particle-iot/power-module/PM-BAT/PM-BAT-V0.5-DXF for shielding case/PM-BAT v0.5-35X22.86-DXF-MAX Components Height 2mm.dxf

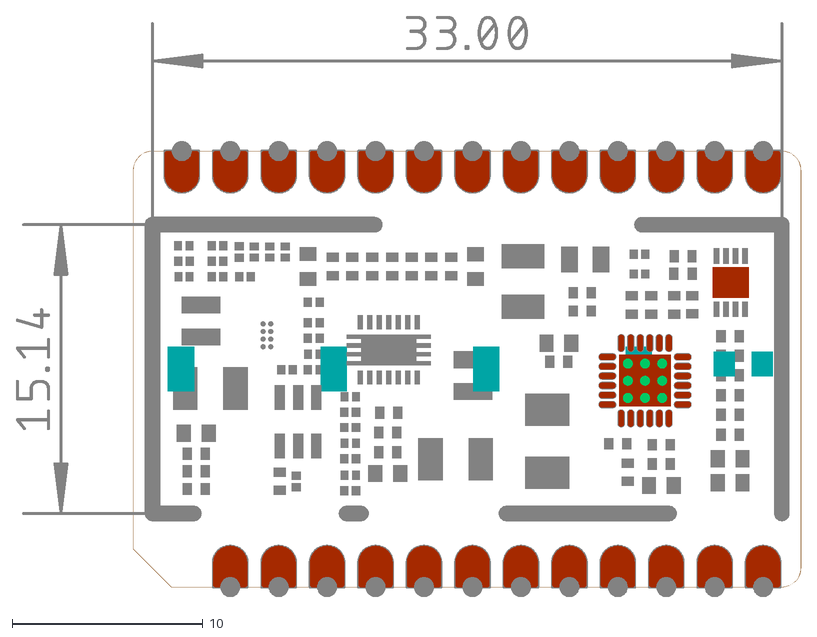
[picture p1: CAD file, 2024-05-06]
PM-BAT/PM-BAT-V0.5-DXF for shielding case/PM-BAT v0.5-35X22.86-DXF-MAX Components Height 2mm.dxf
41.2 x 30.5
