particle-iot/power-module/PM-BAT/V1.0/PM-BAT v1.0-35X22.86-B.dxf

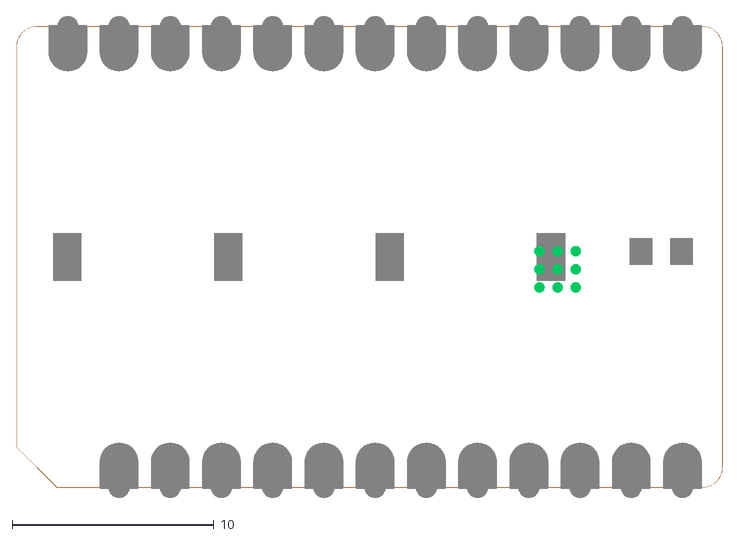
[picture p2: CAD file, 2026-09-03]
PM-BAT/V1.0/PM-BAT v1.0-35X22.86-B.dxf
35.0 x 23.9
