particle-iot/power-module/PM-DC/PM-DC-V0.4 DXF for shielding case/PM_DC_v0.4DXF-MAX Components Height 2mm.dxf

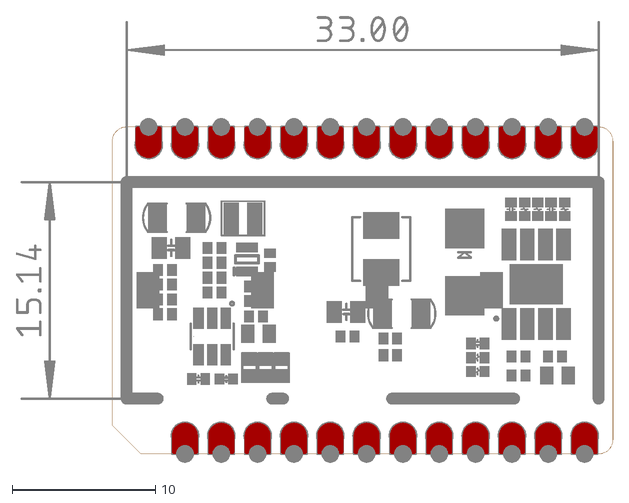
[picture p3: CAD file, 2024-05-06]
PM-DC/PM-DC-V0.4 DXF for shielding case/PM_DC_v0.4DXF-MAX Components Height 2mm.dxf
41.7 x 31.2
