particle-iot/power-module/PM-DC/V1.0/PM_DC_v1.0-T.dxf

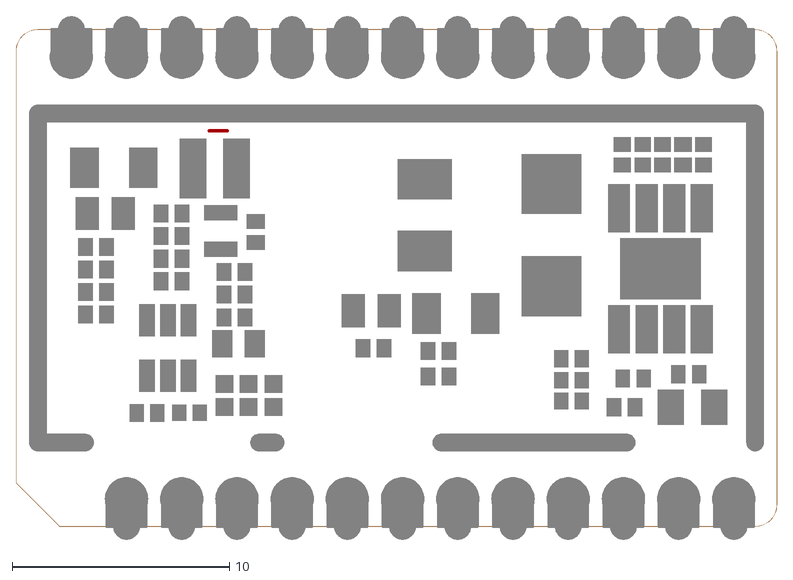
[picture p4: CAD file, 2026-09-03]
PM-DC/V1.0/PM_DC_v1.0-T.dxf
35.0 x 24.1
