particle-iot/power-module/PM-BAT/V1.0/PM-BAT v1.0-35X22.86-T.dxf

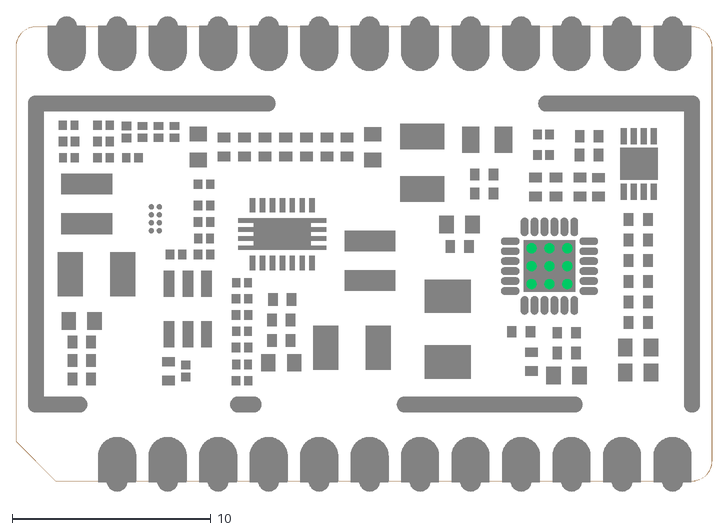
[picture p5: CAD file, 2026-09-03]
PM-BAT/V1.0/PM-BAT v1.0-35X22.86-T.dxf
35.0 x 23.9
