particle-iot/power-module/PM-DC/V1.0/PM_DC_v1.0-B.dxf

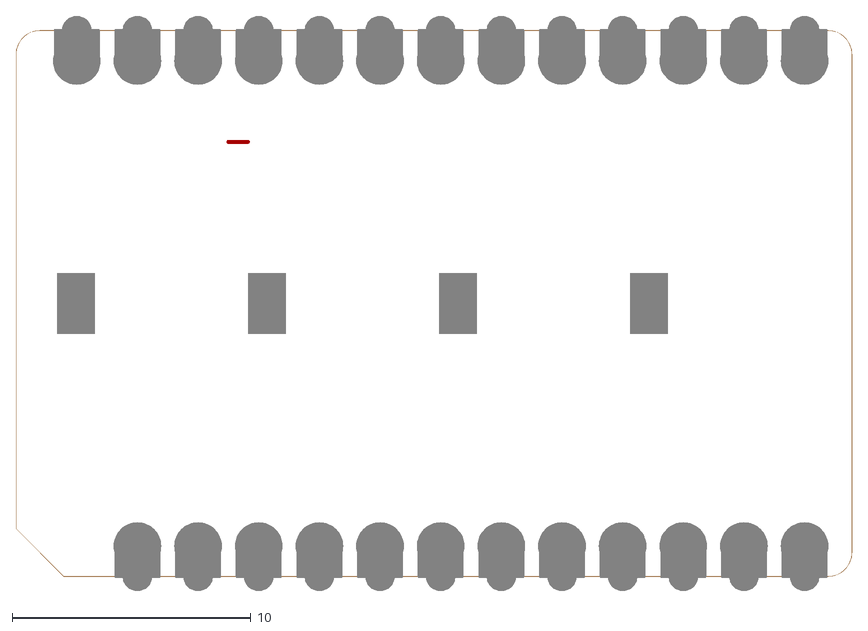
[picture p6: CAD file, 2026-09-03]
PM-DC/V1.0/PM_DC_v1.0-B.dxf
35.0 x 24.1
