particle-iot/power-module/PM-BAT/PM-BAT-V0.5-DXF for shielding case/PM-BAT v0.5-35X22.86-DXF_MAX Components Height 2mm.pdf

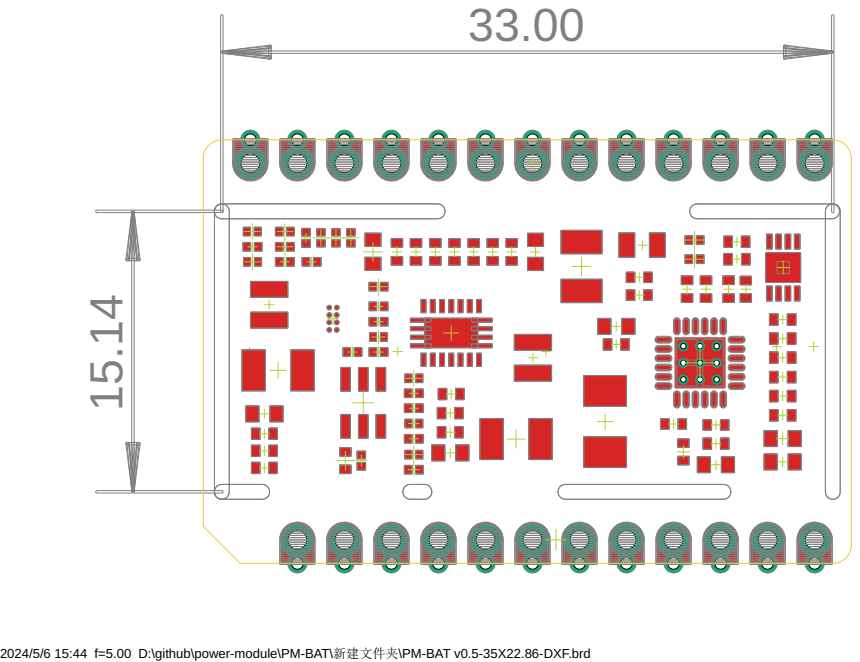
[picture p7: page 1]

2024/5/6 15:44 f=5.00 D:\github\power-module\PM-BAT\新建文件夹\PM-BAT v0.5-35X22.86-DXF.brd
