particle-iot/power-module/PM-DC/PM-DC-V0.4 DXF for shielding case/PM_DC_v0.4DXF-MAX Components Height 2mm.pdf

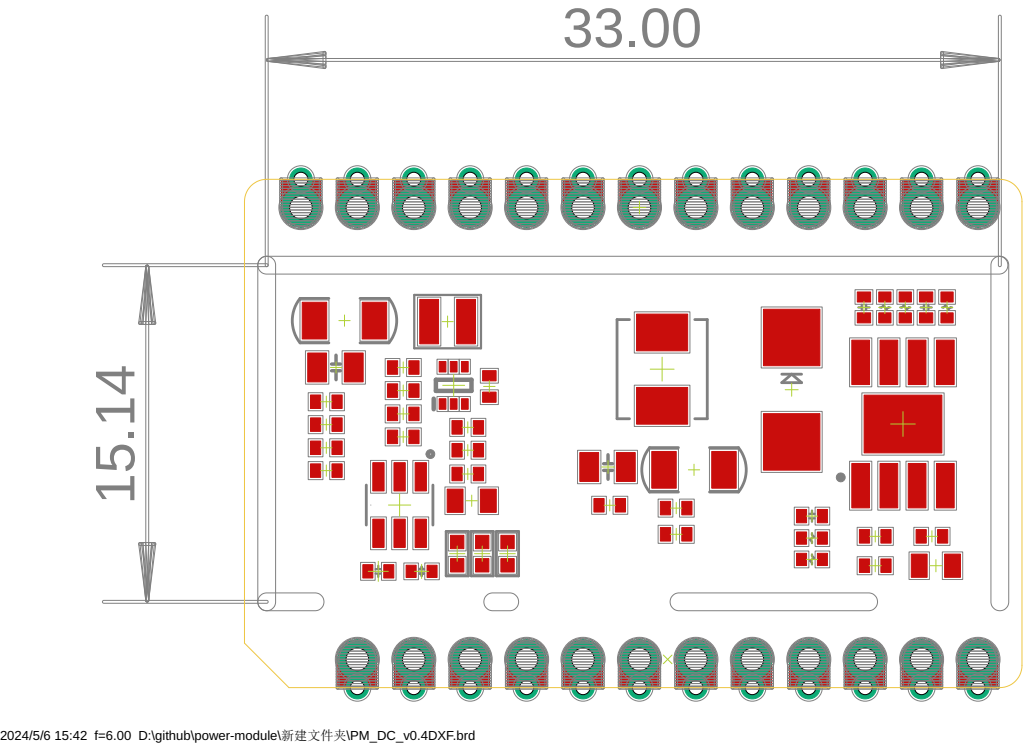
[picture p8: page 1]

2024/5/6 15:42 f=6.00 D:\github\power-module\新建文件夹\PM_DC_v0.4DXF.brd
