particle-iot/power-module/PM-BAT/V1.0/PM-BAT v1.0-35X22.86.pdf

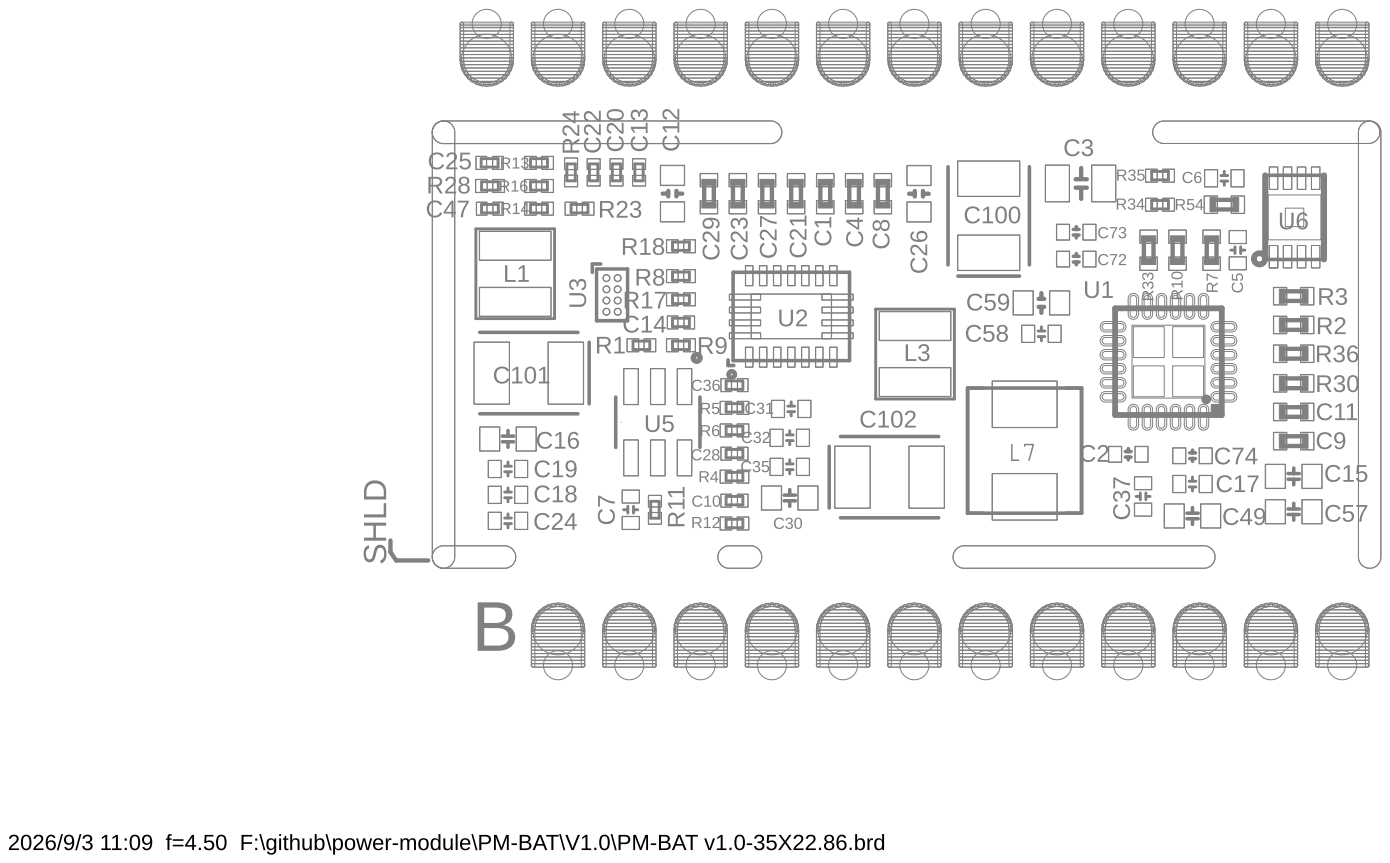
[picture p9: page 1]
