particle-iot/power-module/PM-DC/V1.0/PM_DC_v1.0.pdf

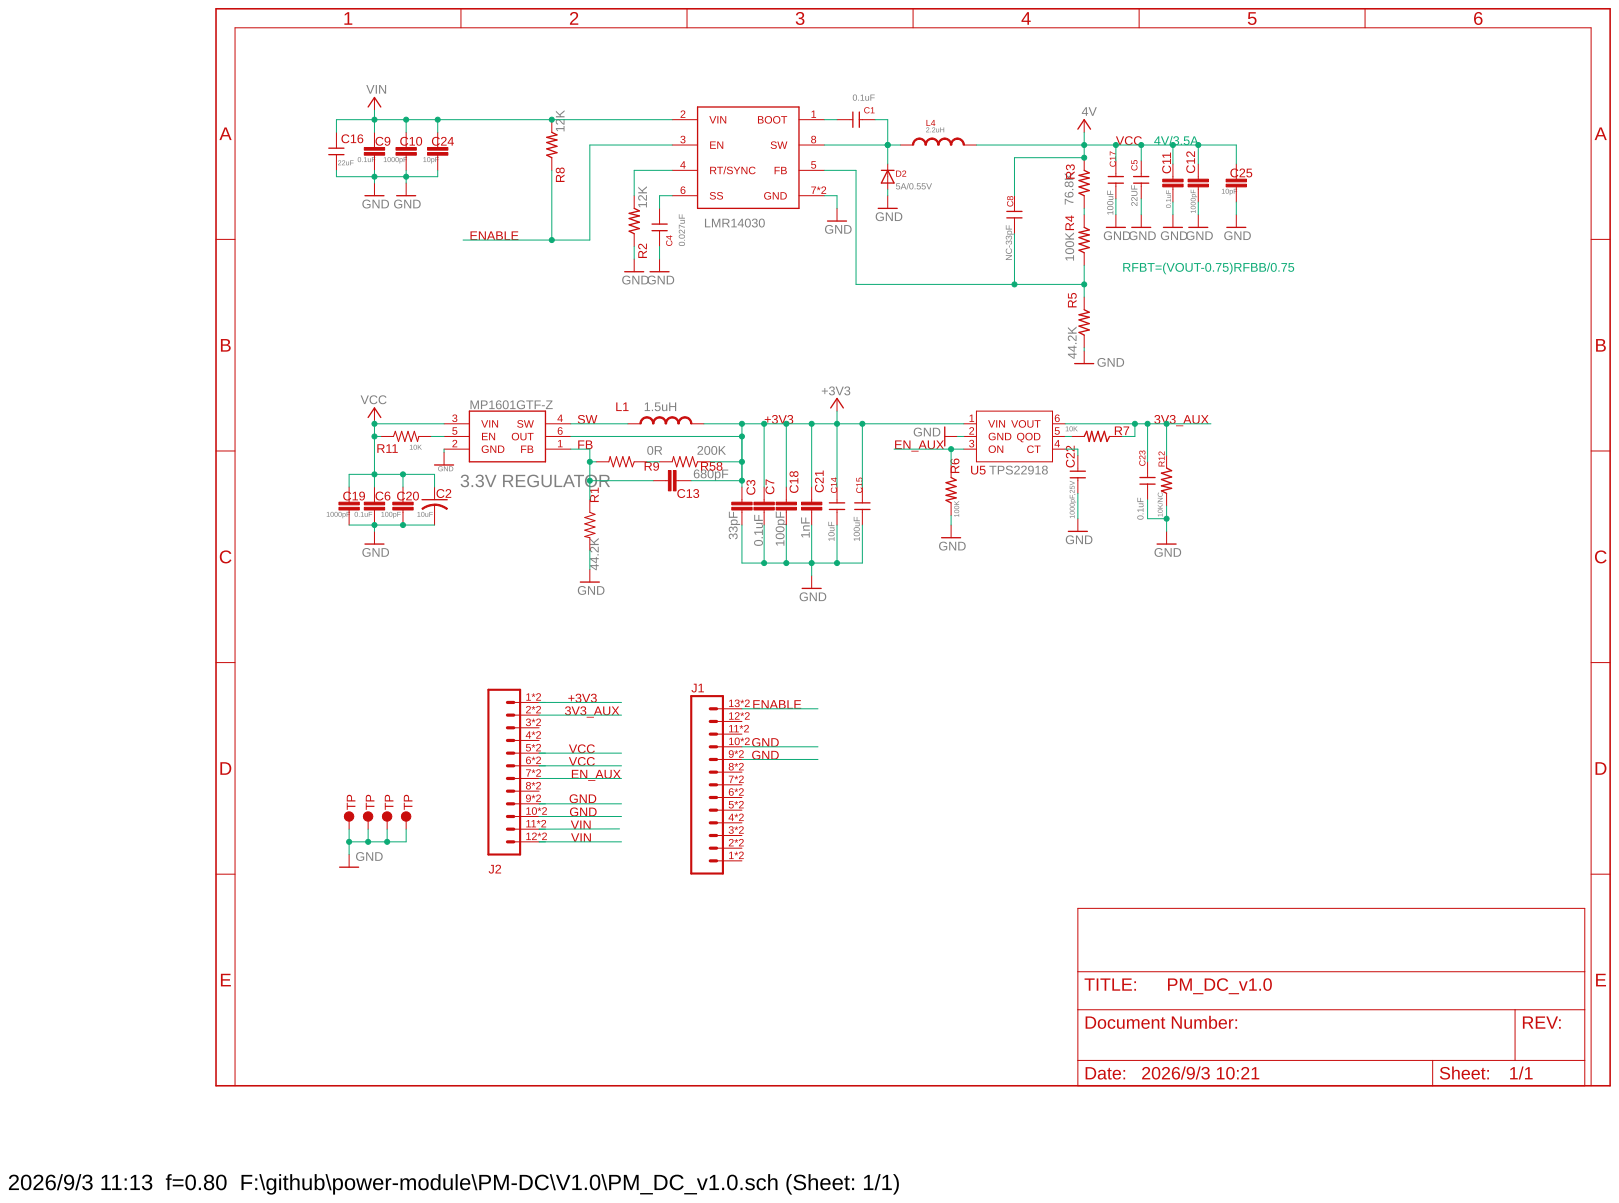
[picture p10: page 1]
