particle-iot/power-module/PM-BAT/V0.5/PM-BAT v0.5-35X22.86.pdf

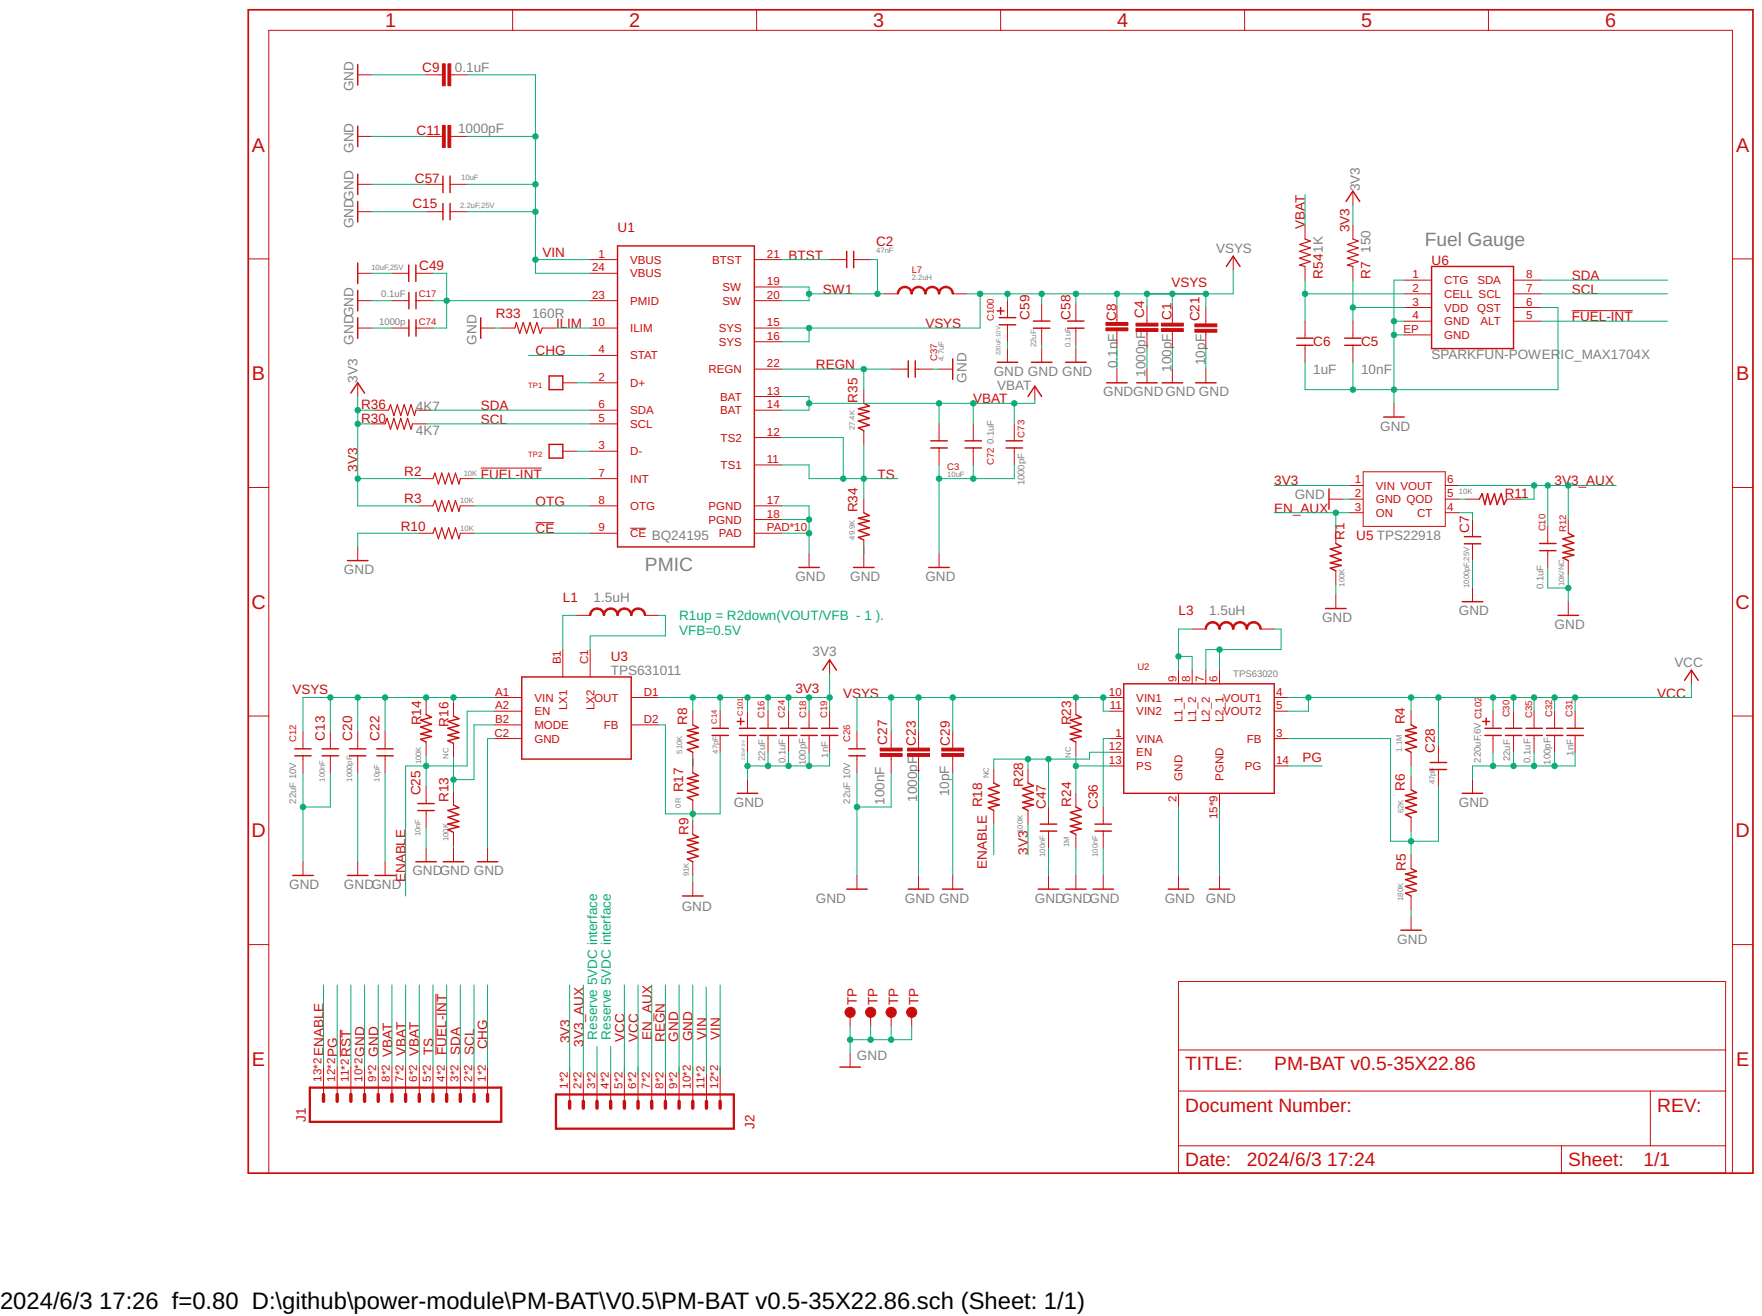
[picture p11: page 1]

Reserve 5VDC interface

2024/6/3 17:26 f=0.80 D:\github\power-module\PM-BAT\V0.5\PM-BAT v0.5-35X22.86.sch (Sheet: 1/1)
