particle-iot/power-module/PM-DC/V0.4/PM_DC_v0.4.pdf

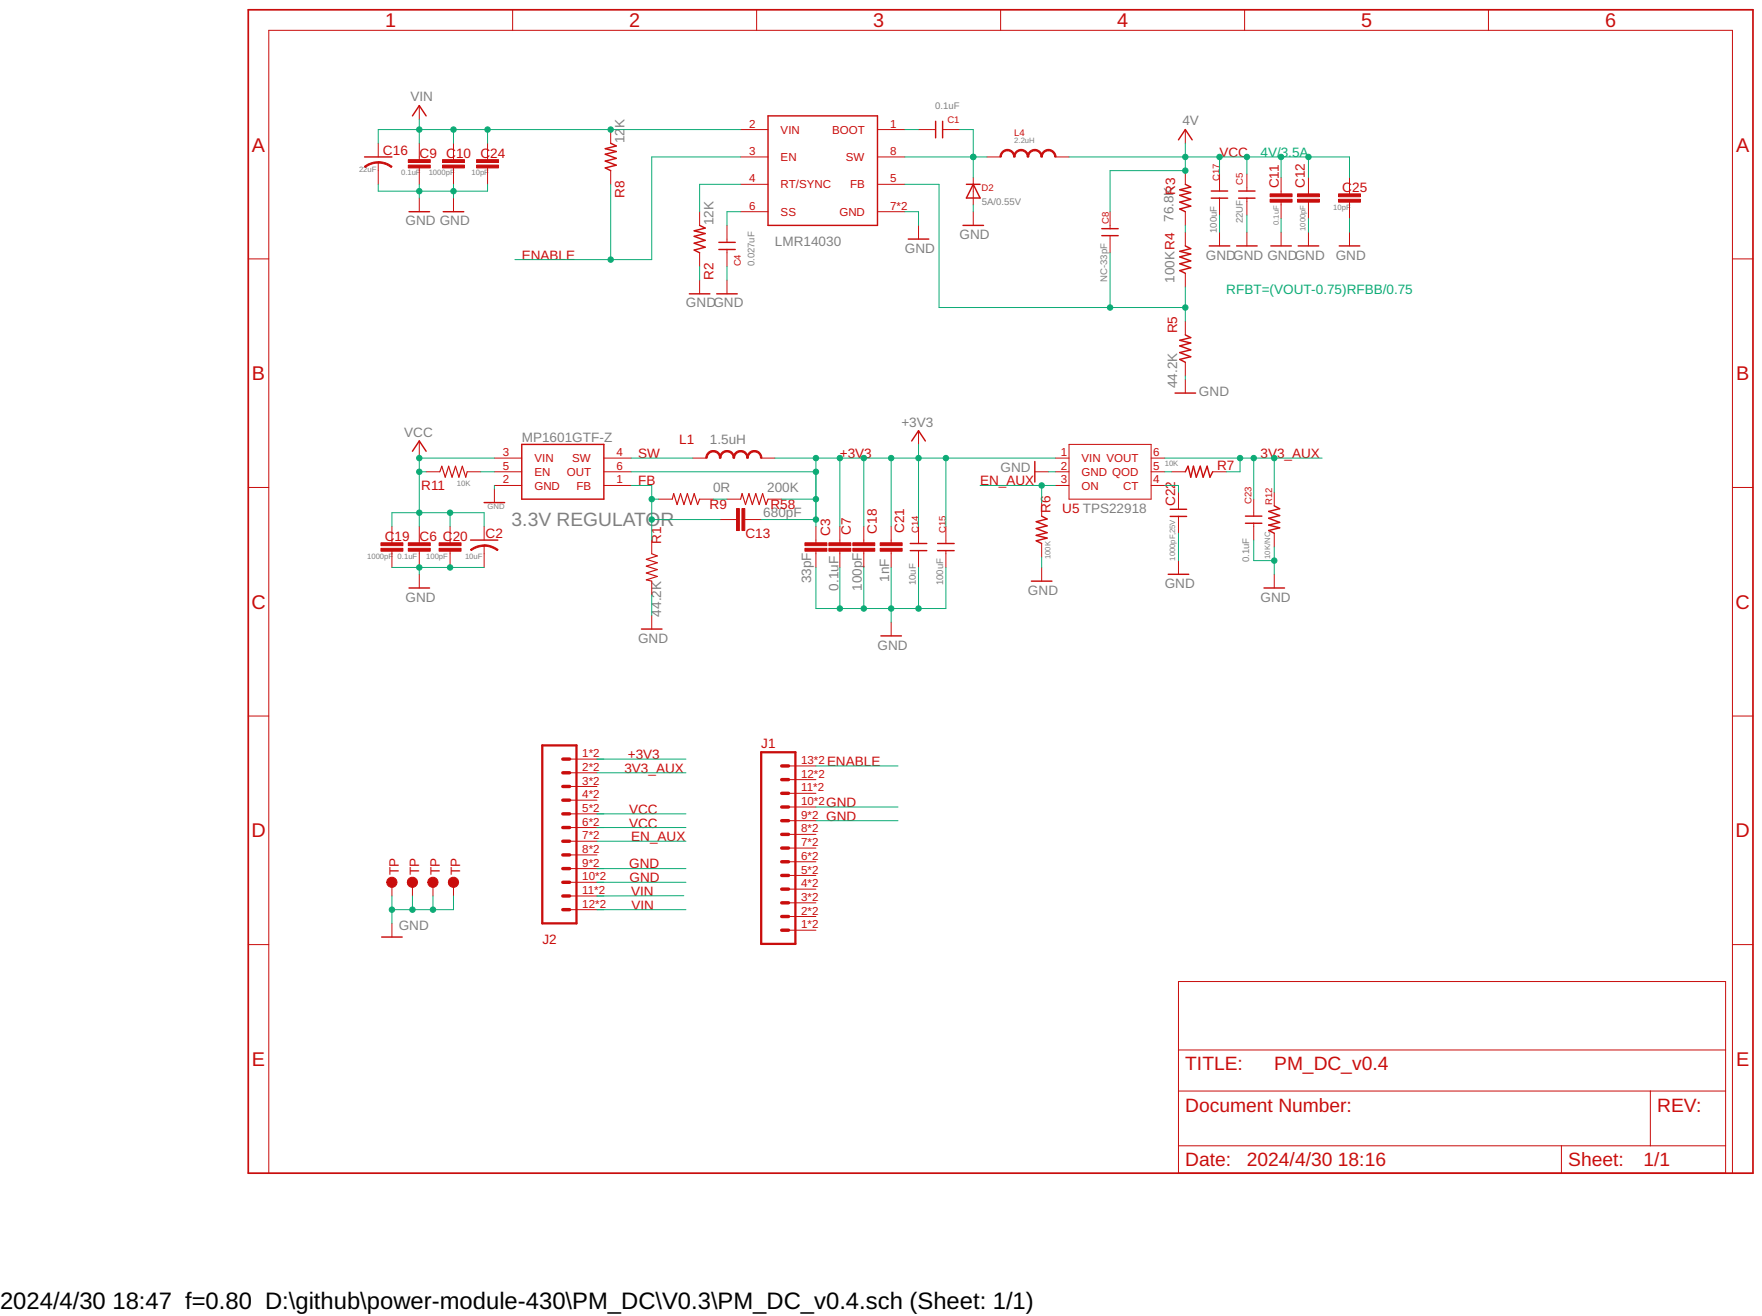
[picture p12: page 1]

2024/4/30 18:47 f=0.80 D:\github\power-module-430\PM_DC\V0.3\PM_DC_v0.4.sch (Sheet: 1/1)
