particle-iot/power-module/PM-BAT/v0.4/PM-BAT v0.4-35X22.86.pdf

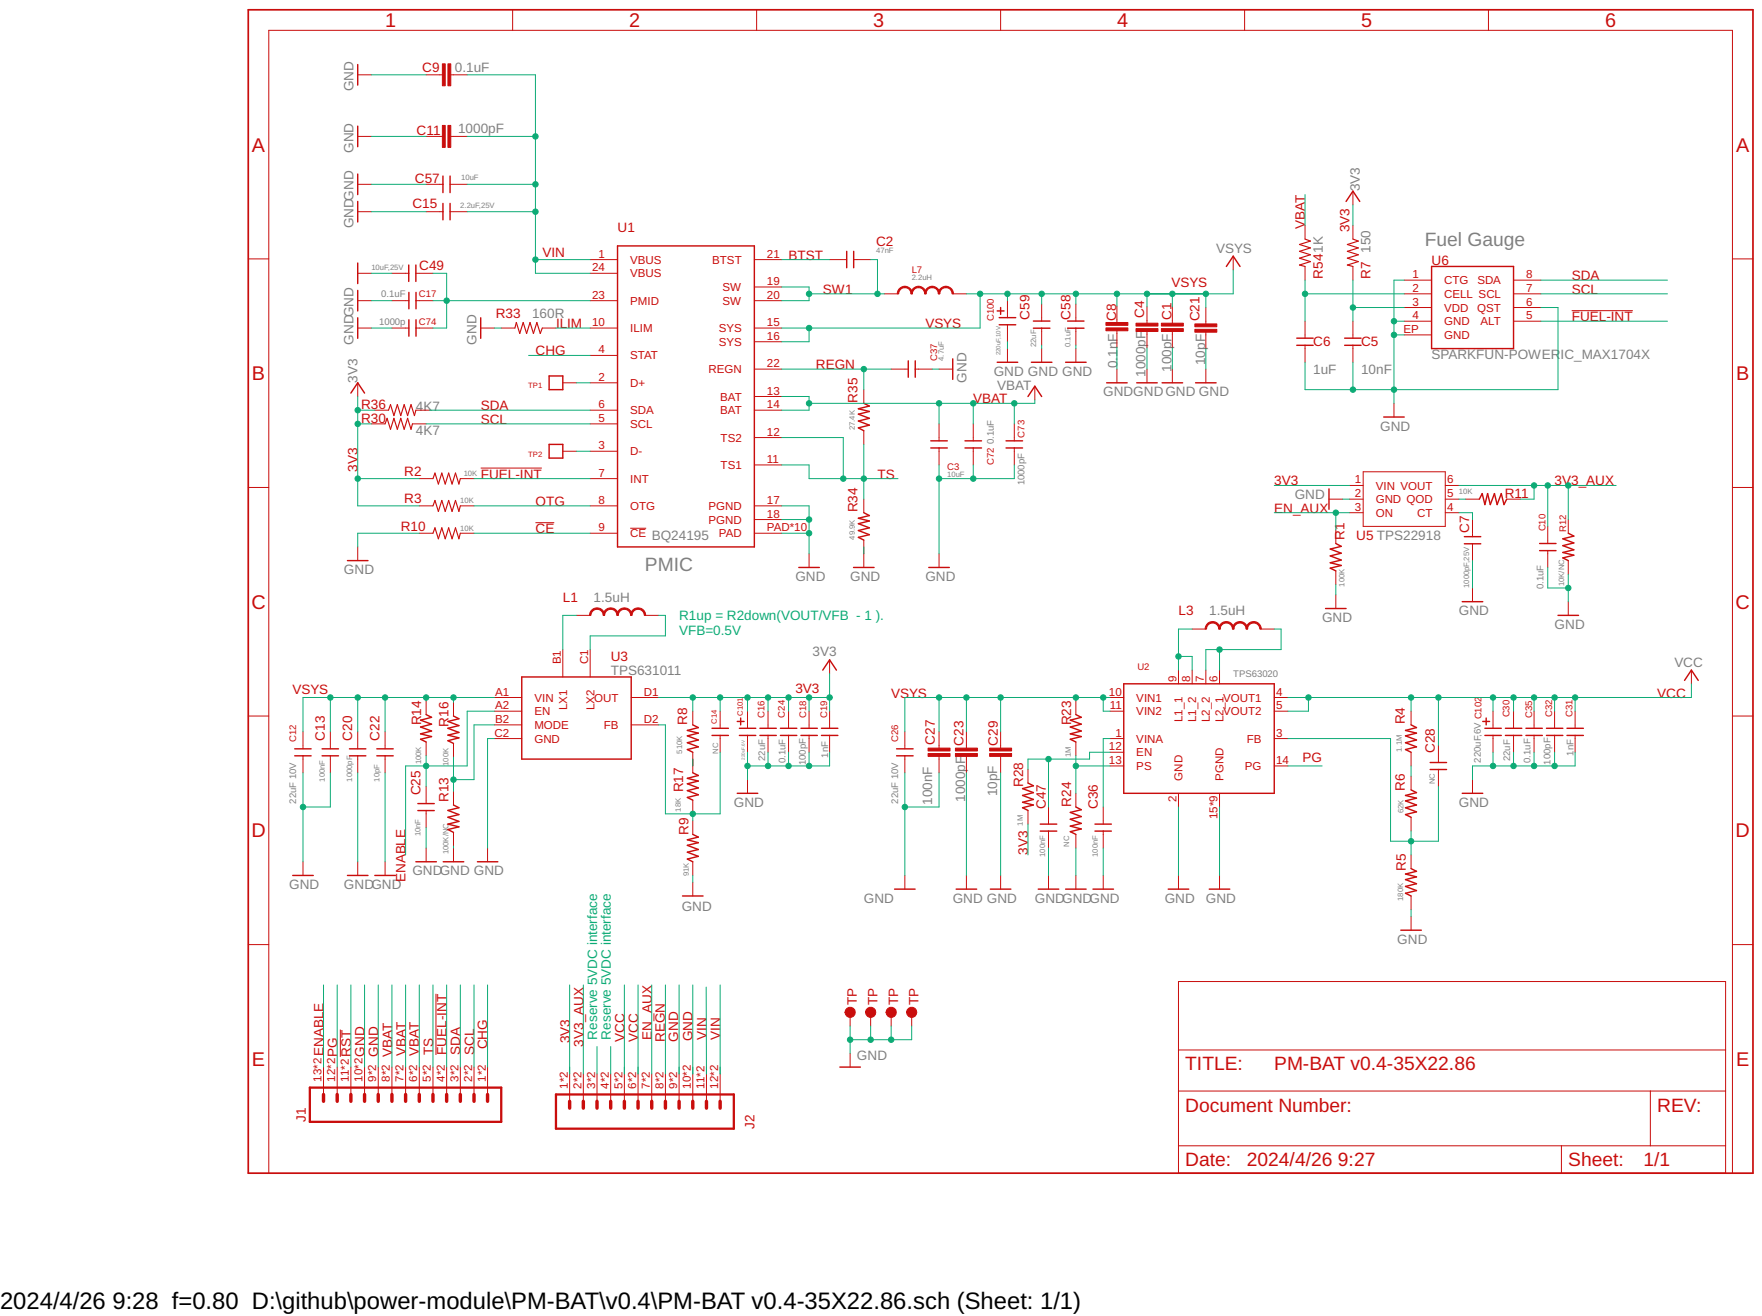
[picture p13: page 1]

Reserve 5VDC interface

2024/4/26 9:28 f=0.80 D:\github\power-module\PM-BAT\v0.4\PM-BAT v0.4-35X22.86.sch (Sheet: 1/1)
