particle-iot/power-module/PM-DC/V0.3/PM_DC_v0.3.pdf

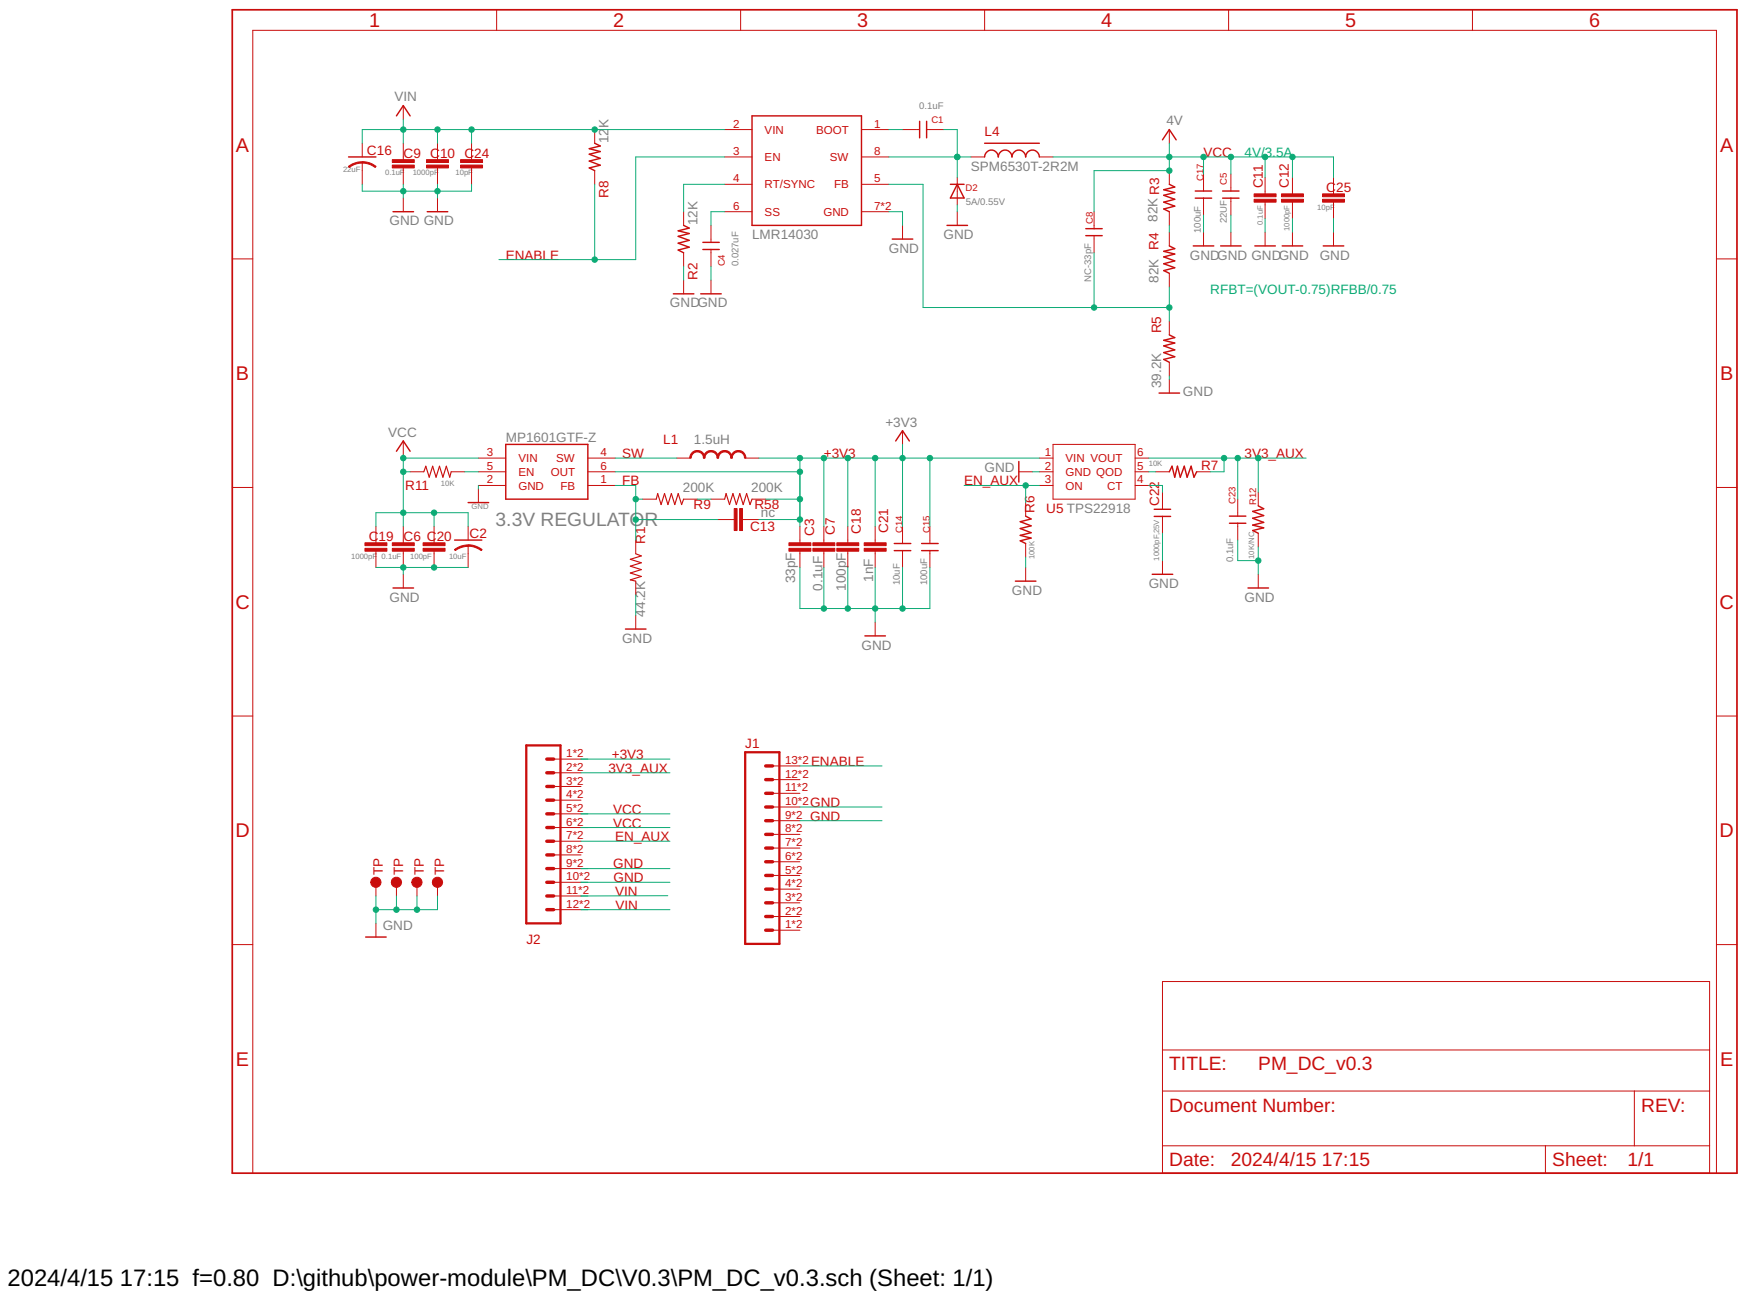
[picture p14: page 1]

2024/4/15 17:15 f=0.80 D:\github\power-module\PM_DC\V0.3\PM_DC_v0.3.sch (Sheet: 1/1)
