particle-iot/power-module/PM-BAT/V0.1/ELEKTRA-PMIC v0.1-20240201.pdf

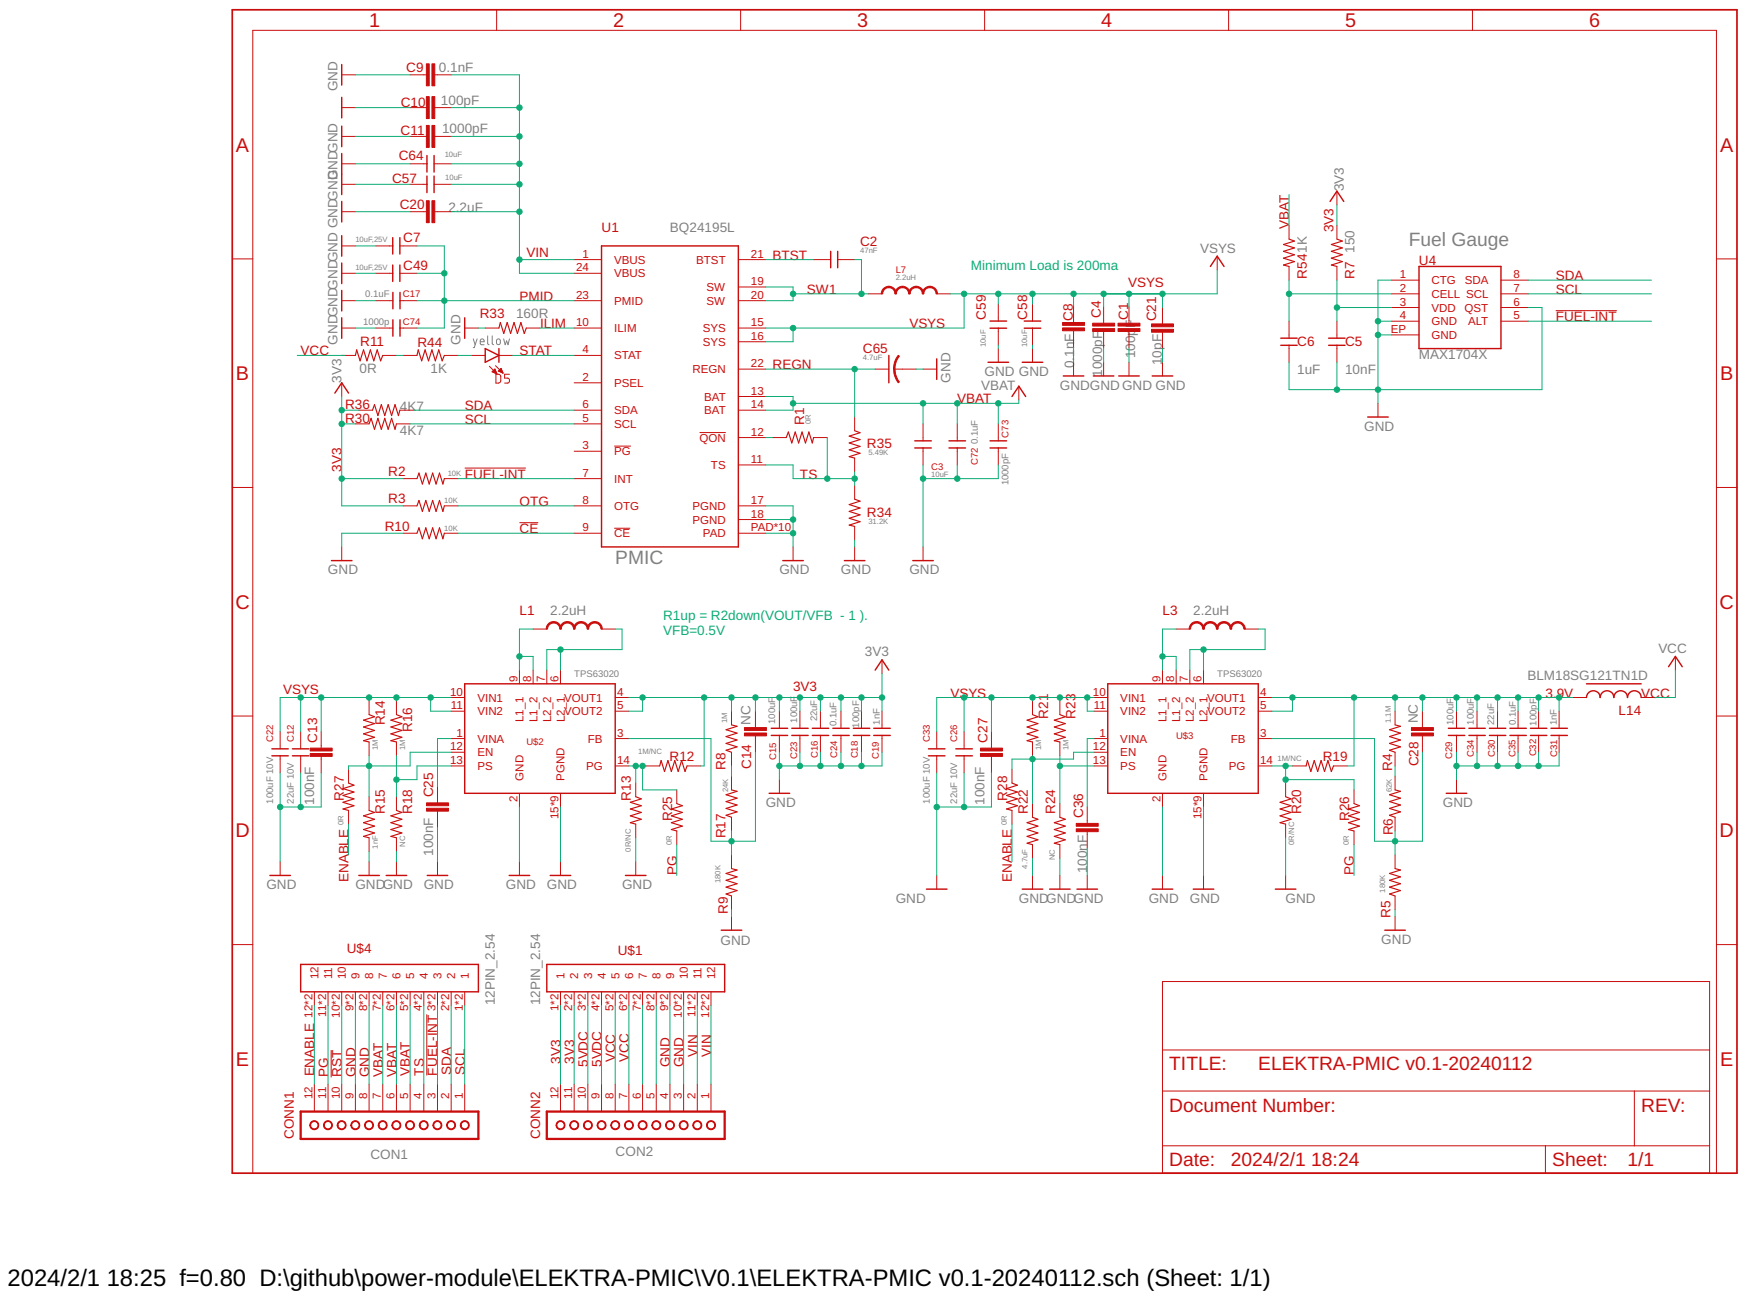
[picture p15: page 1]

2024/2/1 18:25 f=0.80 D:\github\power-module\ELEKTRA-PMIC\V0.1\ELEKTRA-PMIC v0.1-20240112.sch (Sheet: 1/1)
