particle-iot/power-module/PM-DC/V0.1/ELEKTRA-BENCH v0.1-20240201.pdf

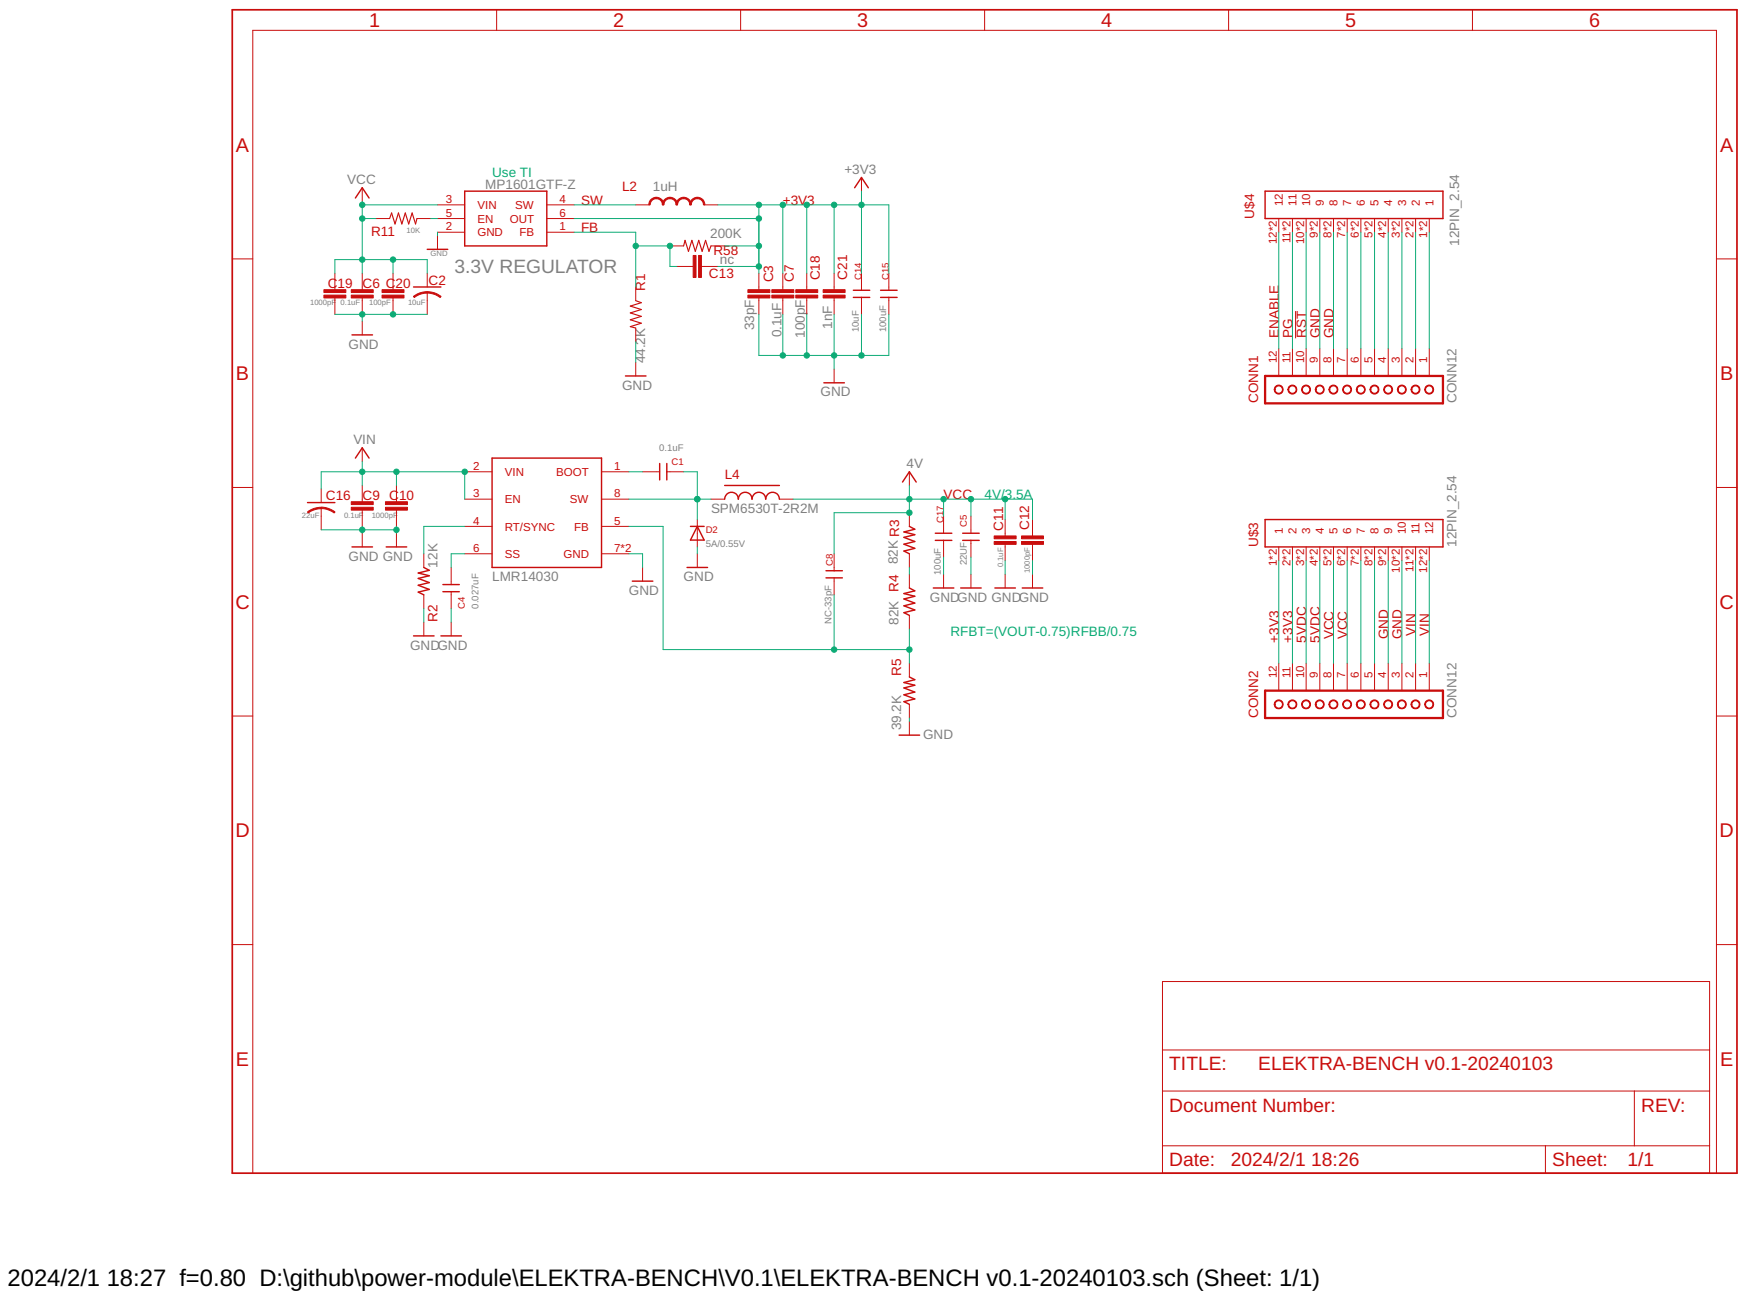
[picture p16: page 1]

12*2 U$4 GND GND GND GND

2024/2/1 18:27 f=0.80 D:\github\power-module\ELEKTRA-BENCH\V0.1\ELEKTRA-BENCH v0.1-20240103.sch (Sheet: 1/1)
