particle-iot/power-module/PM-BAT/V0.5/xydate and placement for PM-BAT/PM-BAT -SMT-placement.pdf

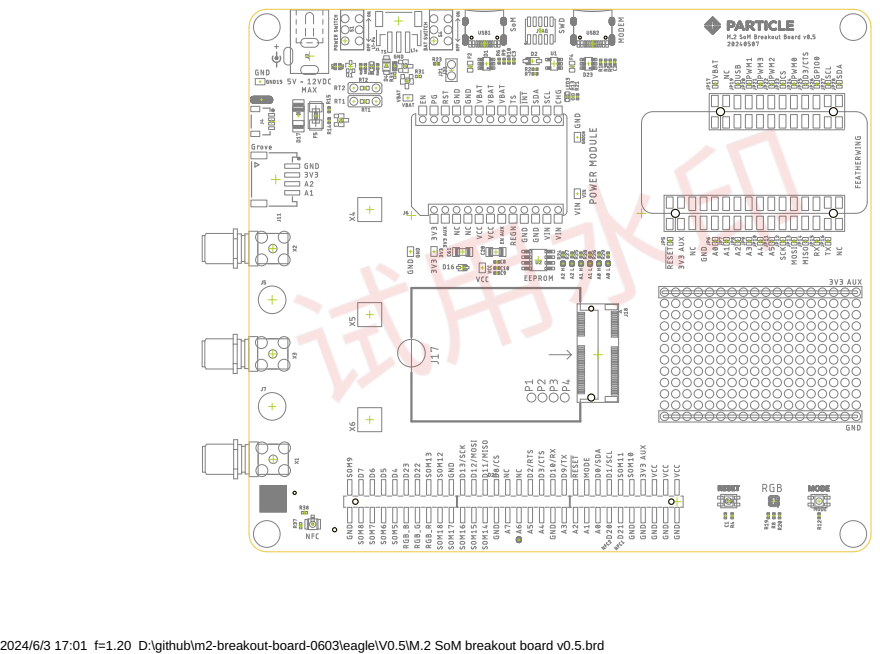
[picture p17: page 1]

2024/6/3 17:01 f=1.20 D:\github\m2-breakout-board-0603\eagle\V0.5\M.2 SoM breakout board v0.5.brd

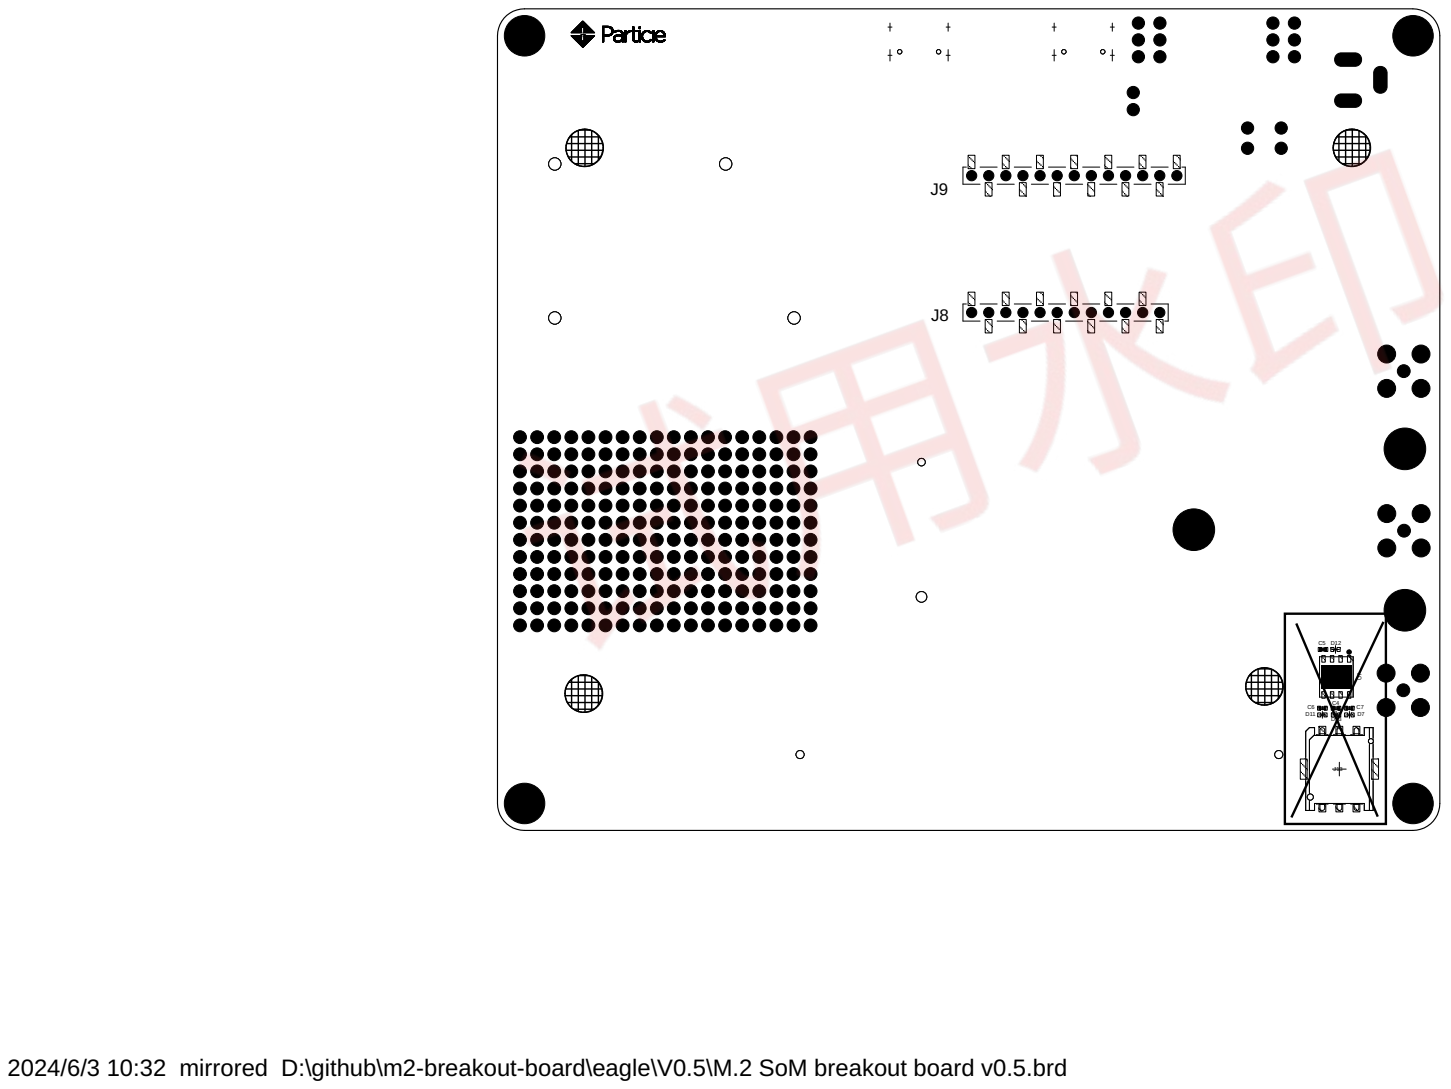
[picture p18: page 2]

2024/6/3 10:32 mirrored D:\github\m2-breakout-board\eagle\V0.5\M.2 SoM breakout board v0.5.brd
