particle-iot/power-module/PM-DC/V0.4/xydate and placement for PM-DC/PM-DC-SMT-placement.pdf

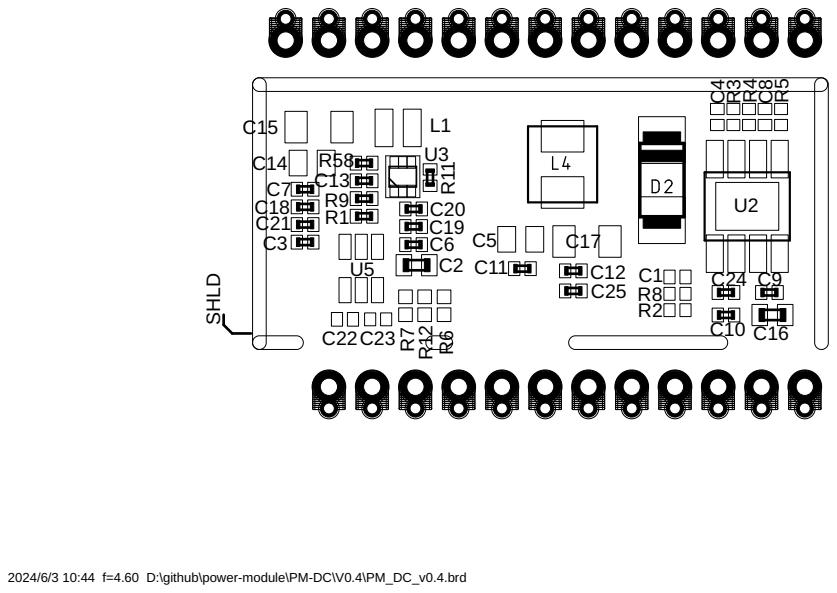
[picture p19: page 1]

2024/6/3 10:44 f=4.60 D:\github\power-module\PM-DC\V0.4\PM_DC_v0.4.brd

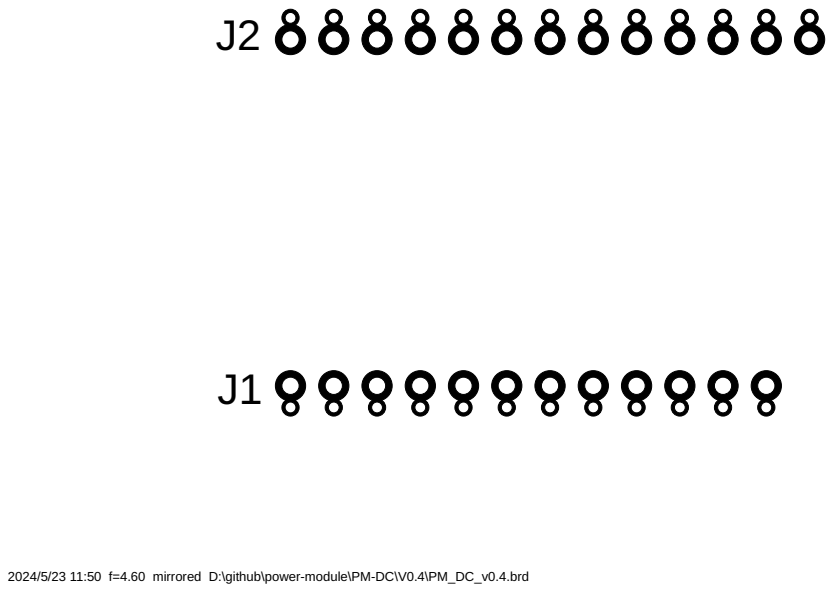
[picture p20: page 2]

2024/5/23 11:50 f=4.60 mirrored D:\github\power-module\PM-DC\V0.4\PM_DC_v0.4.brd
