particle-iot/power-module/PM-BAT/V0.1/PM-BAT/v0.4/PM-BAT v0.4-35X22.86.pdf

## Fuel Gauge

A

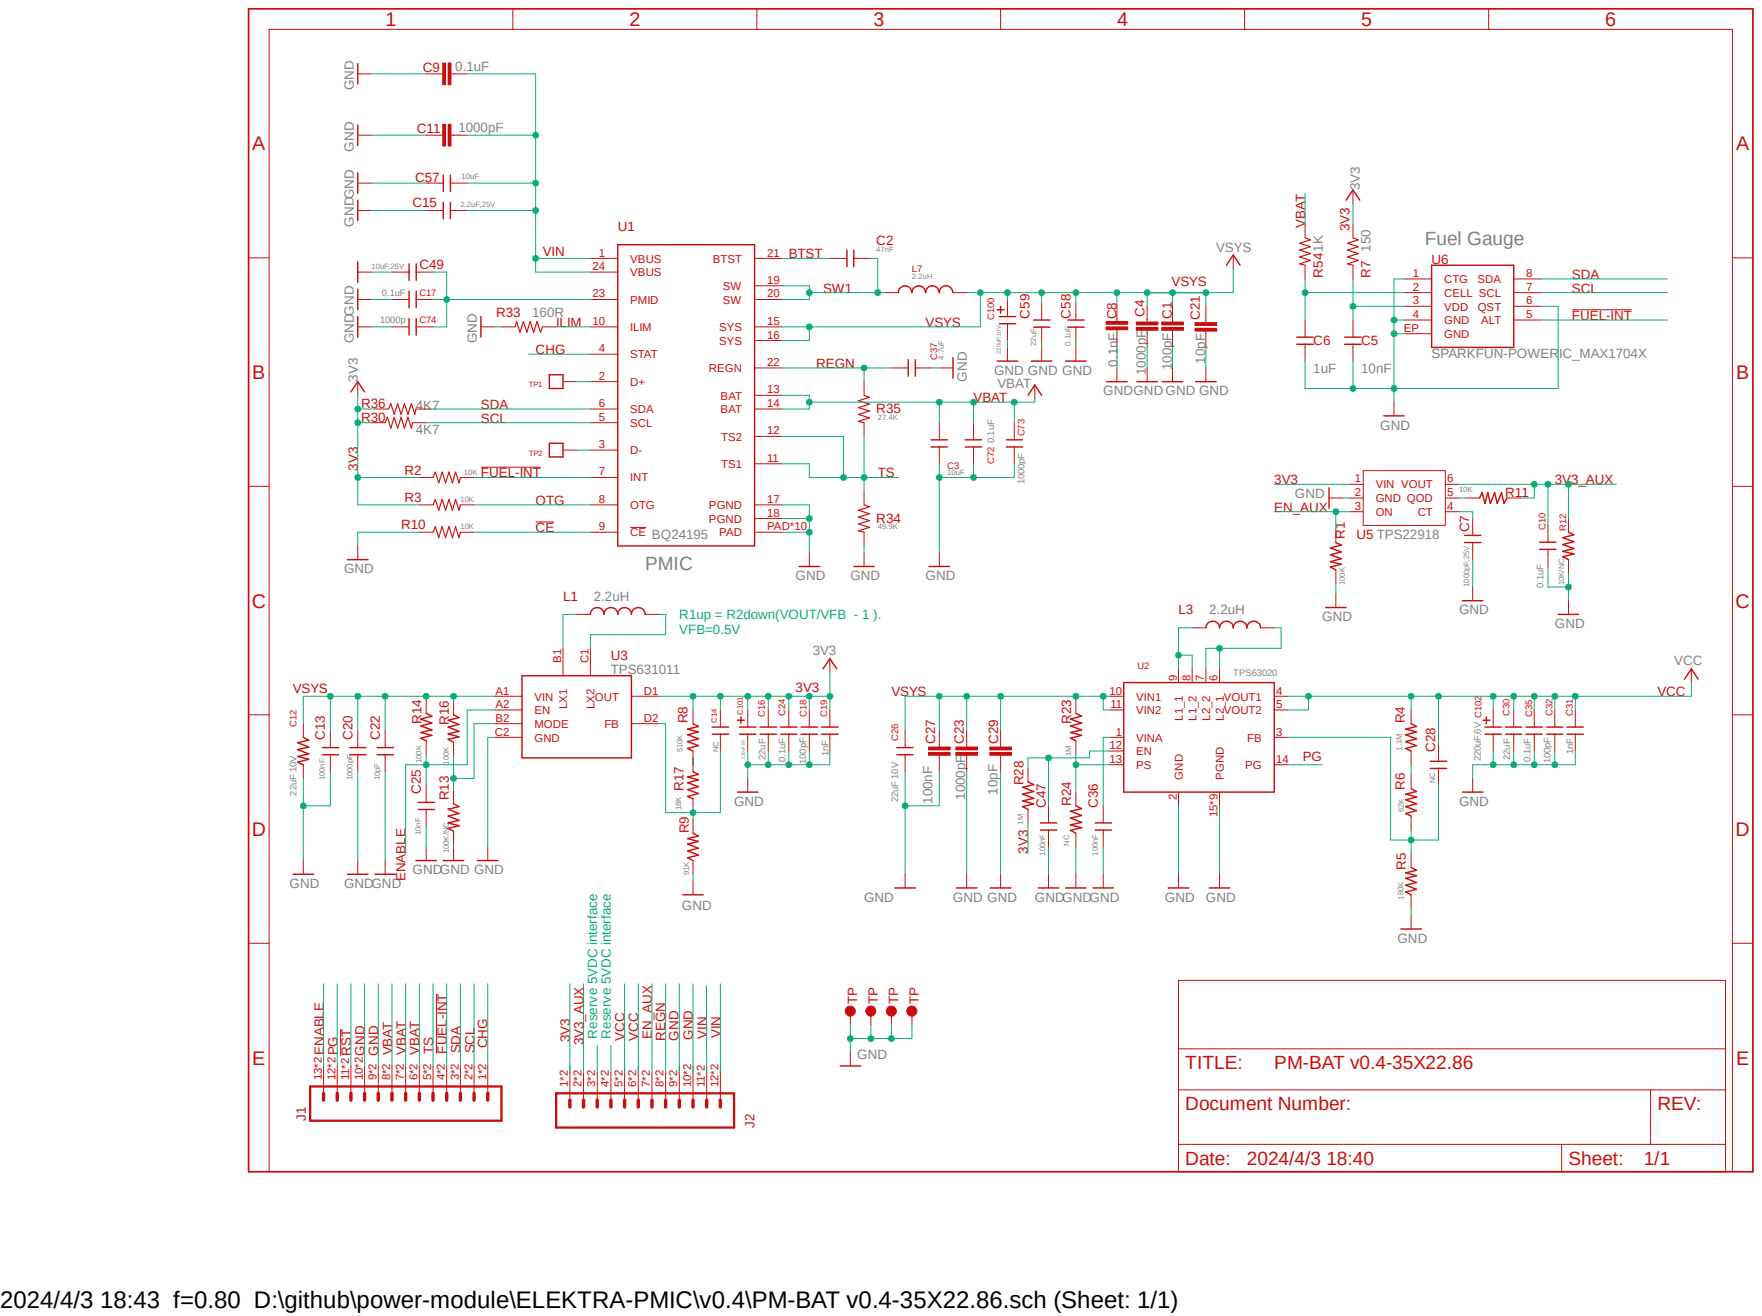
[picture p21: page 1]

4 | SPARKFUN-POWERIC_MAX1704X

Document Number: | REV:

Date: 2024/4/3 18:40 | Sheet: 1/1

2024/4/3 18:43 f=0.80 D:\github\power-module\ELEKTRA-PMIC\v0.4\PM-BAT v0.4-35X22.86.sch (Sheet: 1/1)
