particle-iot/power-module/PowerModule_TestBoard/eagle/powerModule_v0.0.1/PowerModule_Testboard.pdf

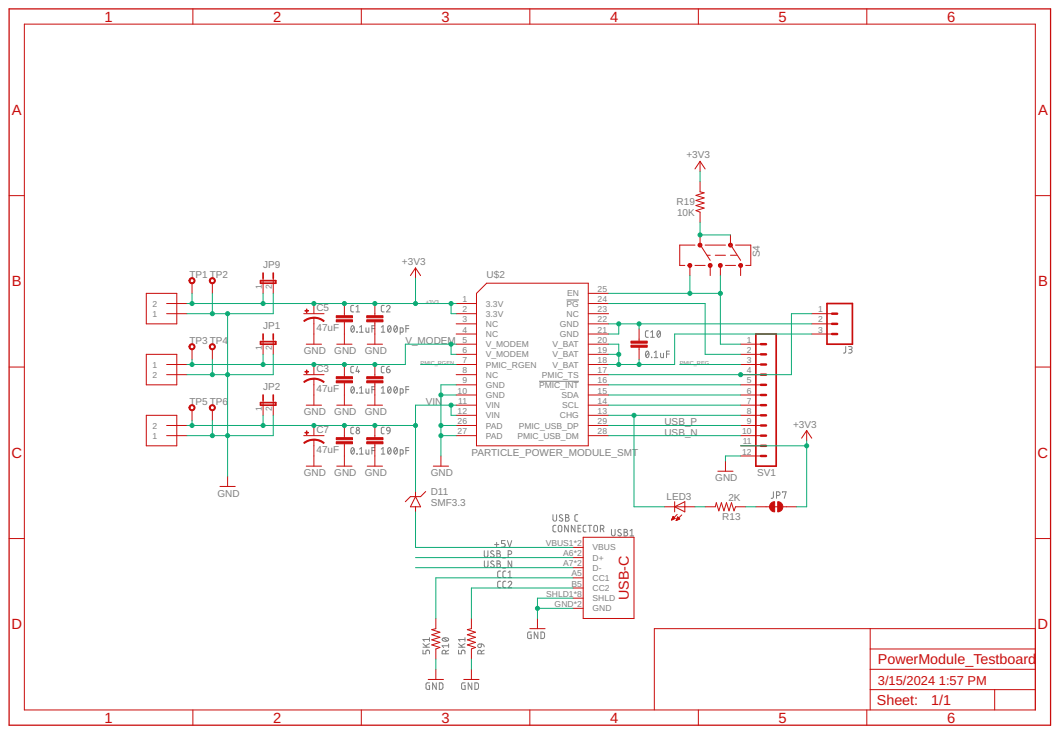
[picture p22: page 1]
