particle-iot/power-module/PM-DC/V1.0/PM_DC_v1.0.brd

## EAGLE design PM-DC/V1.0/PM_DC_v1.0.brd (2026-09-03)

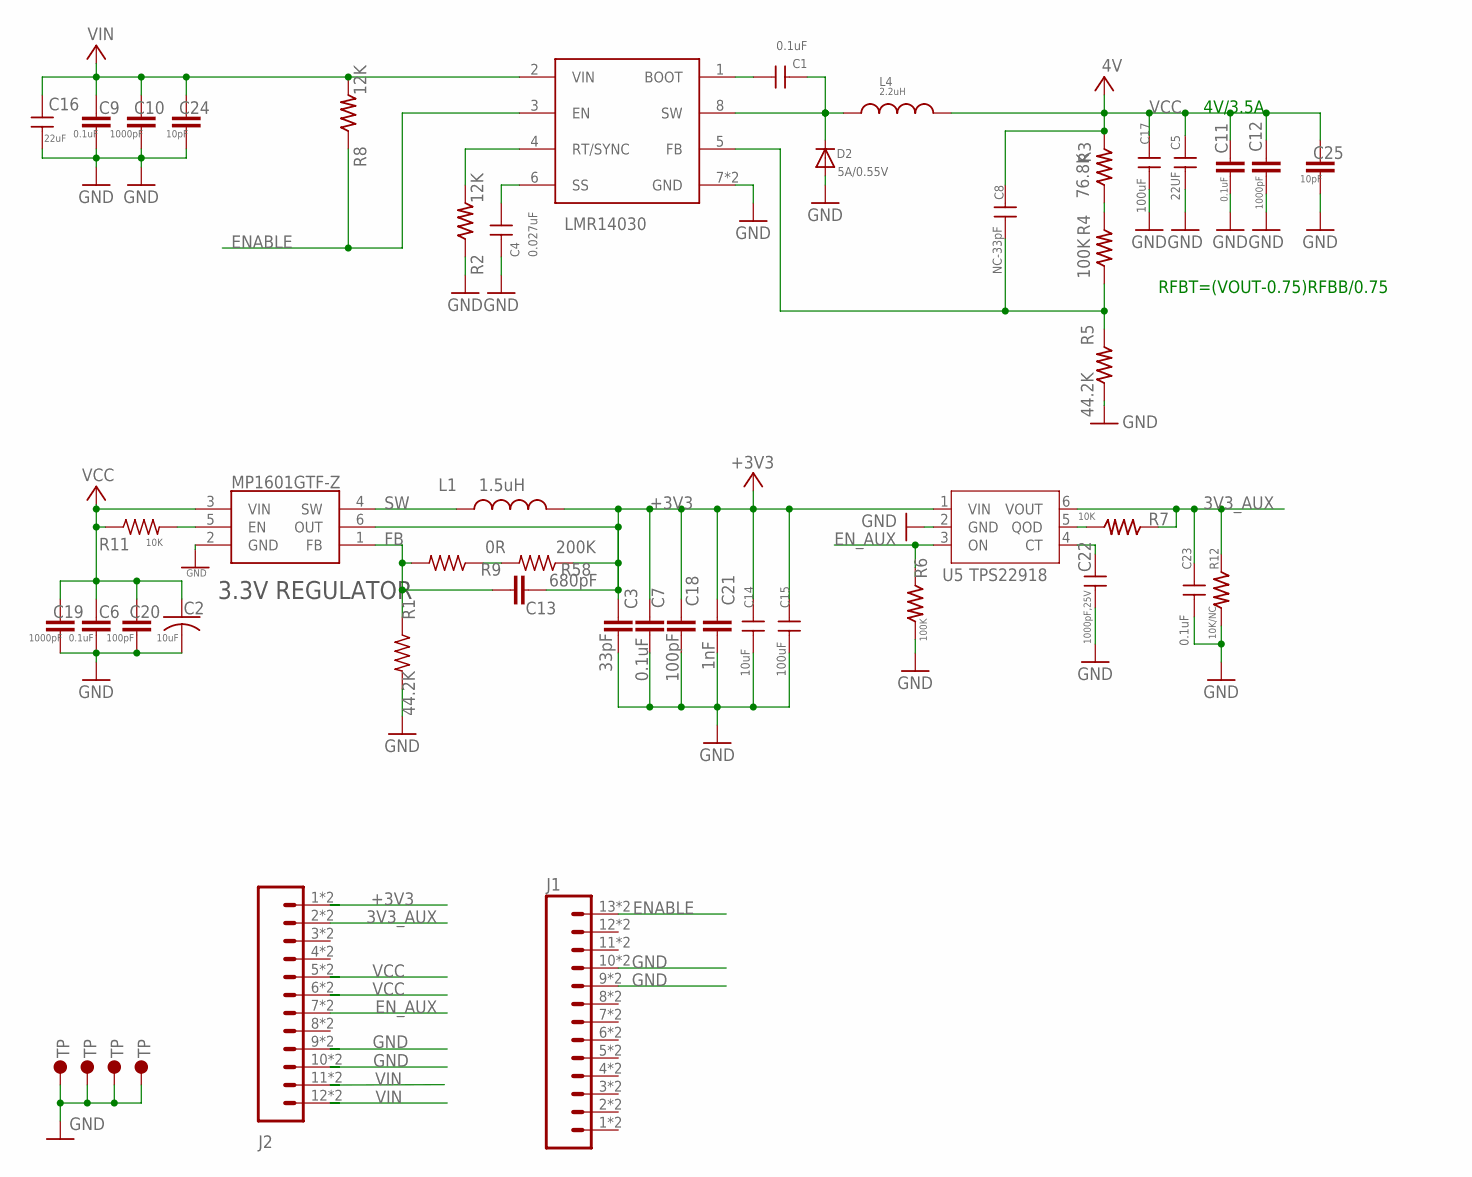
[picture p23: schematic PM_DC_v1.0.sch]

Parts:
C1: 0.1uF; C0402
C2: 10uF; C0603_B
C3: 33pF; C0402_B
C4: 0.027uF; C0402
C5: 22UF; C0805
C6, C7, C9, C11: 0.1uF; C0402_B
C8: NC-33pF; C0402
C10, C12, C19: 1000pF; C0402_B
C13: 680pF; C0402_B
C14: 10uF; C0805
C15, C17: 100uF; C1206
C16: 22uF; C805
C18, C20: 100pF; C0402_B
C21: 1nF; C0402_B
C22: 1000pF,25V; C0402
C23: 0.1uF; C-0402
C24, C25: 10pF; C0402_B
D2: 5A/0.55V; SMADIODE
J1: M13PTH-CST-R; 1X13-CASTELLATED
J2: M12PTH-CST-R; 1X12-CASTELLATED
L1: 1.5uH; INDUCTOR-2520
L4: 2.2uH; INDUCTOR-4040
R1: 44.2K; R0402_B
R2, R8: 12K; R-0402S
R3: 76.8K; R-0402S
R4: 100K; R-0402S
R5: 44.2K; R-0402S
R6: 100K; R0402
R7: 10K; R0402
R9: 0R; R0402_B
R11: 10K; R0402_B
R12: 10K/NC; R0402
R58: 200K; R0402_B
U2: LMR14030; SO_POWERPAD_8
U3: MP1601GTF-Z; SOTFL50P160X60-6N
U5: TPS22918; SOT-23-6
U$1, U$2, U$4, U$5: TP; TP_2.33X1.37

Connections:
3V3_AUX: C23.1, J2.2, J2.@2 (2), R7.1, R12.1, U5.6 (VOUT)
+3V3: C3.2, C7.2, C13.1, C14.1, C15.1, C18.2, C21.2, J2.1, J2.@1 (1), L1.2, R58.1, U3.6 (OUT), U5.1 (VIN)
ENABLE: J1.13, J1.@13 (13), R8.1, U2.3 (EN)
EN_AUX: J2.7, J2.@7 (7), R6.1, U5.3 (ON)
FB: C13.2, R1.1, R9.2, U3.1 (FB)
GND: C2.2, C3.1, C4.2, C5.2, C6.1, C7.1, C9.1, C10.1, C11.1, C12.1, C14.2, C15.2, C16.2, C17.2, C18.1, C19.1, C20.1, C21.1, C22.2, C23.2, C24.1, C25.1, D2.A, J1.9, J1.10, J1.@9 (9), J1.@10 (10), J2.9, J2.10, J2.@9 (9), J2.@10 (10), R1.2, R2.1, R5.1, R6.2, R12.2, U2.7 (GND), U2.EP (GND), U3.2 (GND), U5.2 (GND), U$1.1, U$2.1, U$4.1, U$5.1
unnamed: R7.2, U5.5 (QOD)
unnamed: C8.1, R4.1, R5.2, U2.5 (FB)
unnamed: R11.2, U3.5 (EN)
unnamed: R9.1, R58.2
unnamed: C4.1, U2.6 (SS)
unnamed: C1.2, D2.C, L4.P$1 (1), U2.8 (SW)
unnamed: C1.1, U2.1 (BOOT)
unnamed: R2.2, U2.4 (RT/SYNC)
unnamed: R3.1, R4.2
unnamed: C22.1, U5.4 (CT)
SW: L1.1, U3.4 (SW)
VCC: C2.1, C5.1, C6.2, C8.2, C11.2, C12.2, C17.1, C19.2, C20.2, C25.2, J2.5, J2.6, J2.@5 (5), J2.@6 (6), L4.P$2 (2), R3.2, R11.1, U3.3 (VIN)
VIN: C9.2, C10.2, C16.1, C24.2, J2.11, J2.12, J2.@11 (11), J2.@12 (12), R8.2, U2.2 (VIN)

Notes on the sheet:
4V/3.5A
3.3V REGULATOR
RFBT=(VOUT-0.75)RFBB/0.75

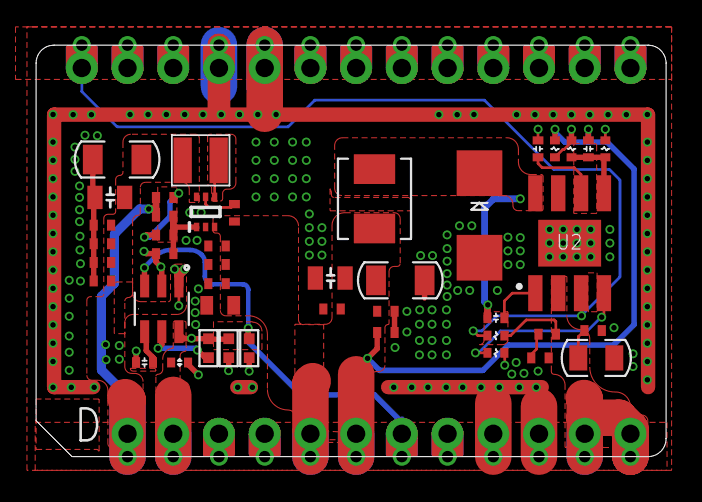
[picture p24: board PM_DC_v1.0.brd from above]

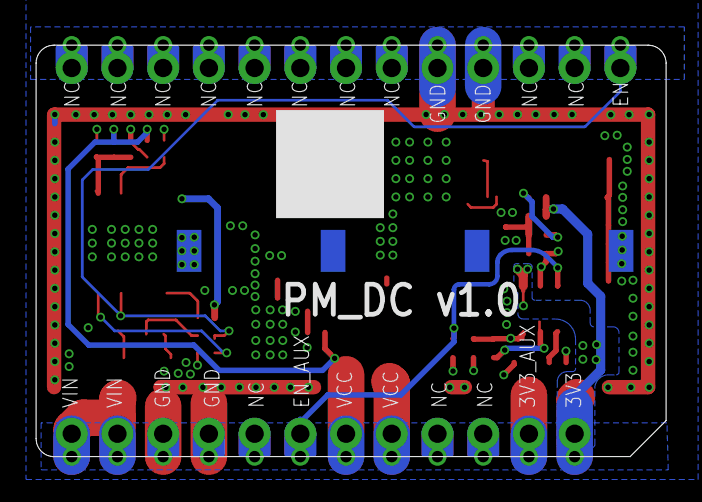
[picture p25: board PM_DC_v1.0.brd from below]

Board: 2 copper layers, 35.0 x 22.9 mm, 49 parts (4 on the bottom side), 19 nets.
