particle-iot/power-module/PM-BAT/V1.0/PM-BAT v1.0-35X22.86.brd

## EAGLE design PM-BAT/V1.0/PM-BAT v1.0-35X22.86.brd (2024-08-02)

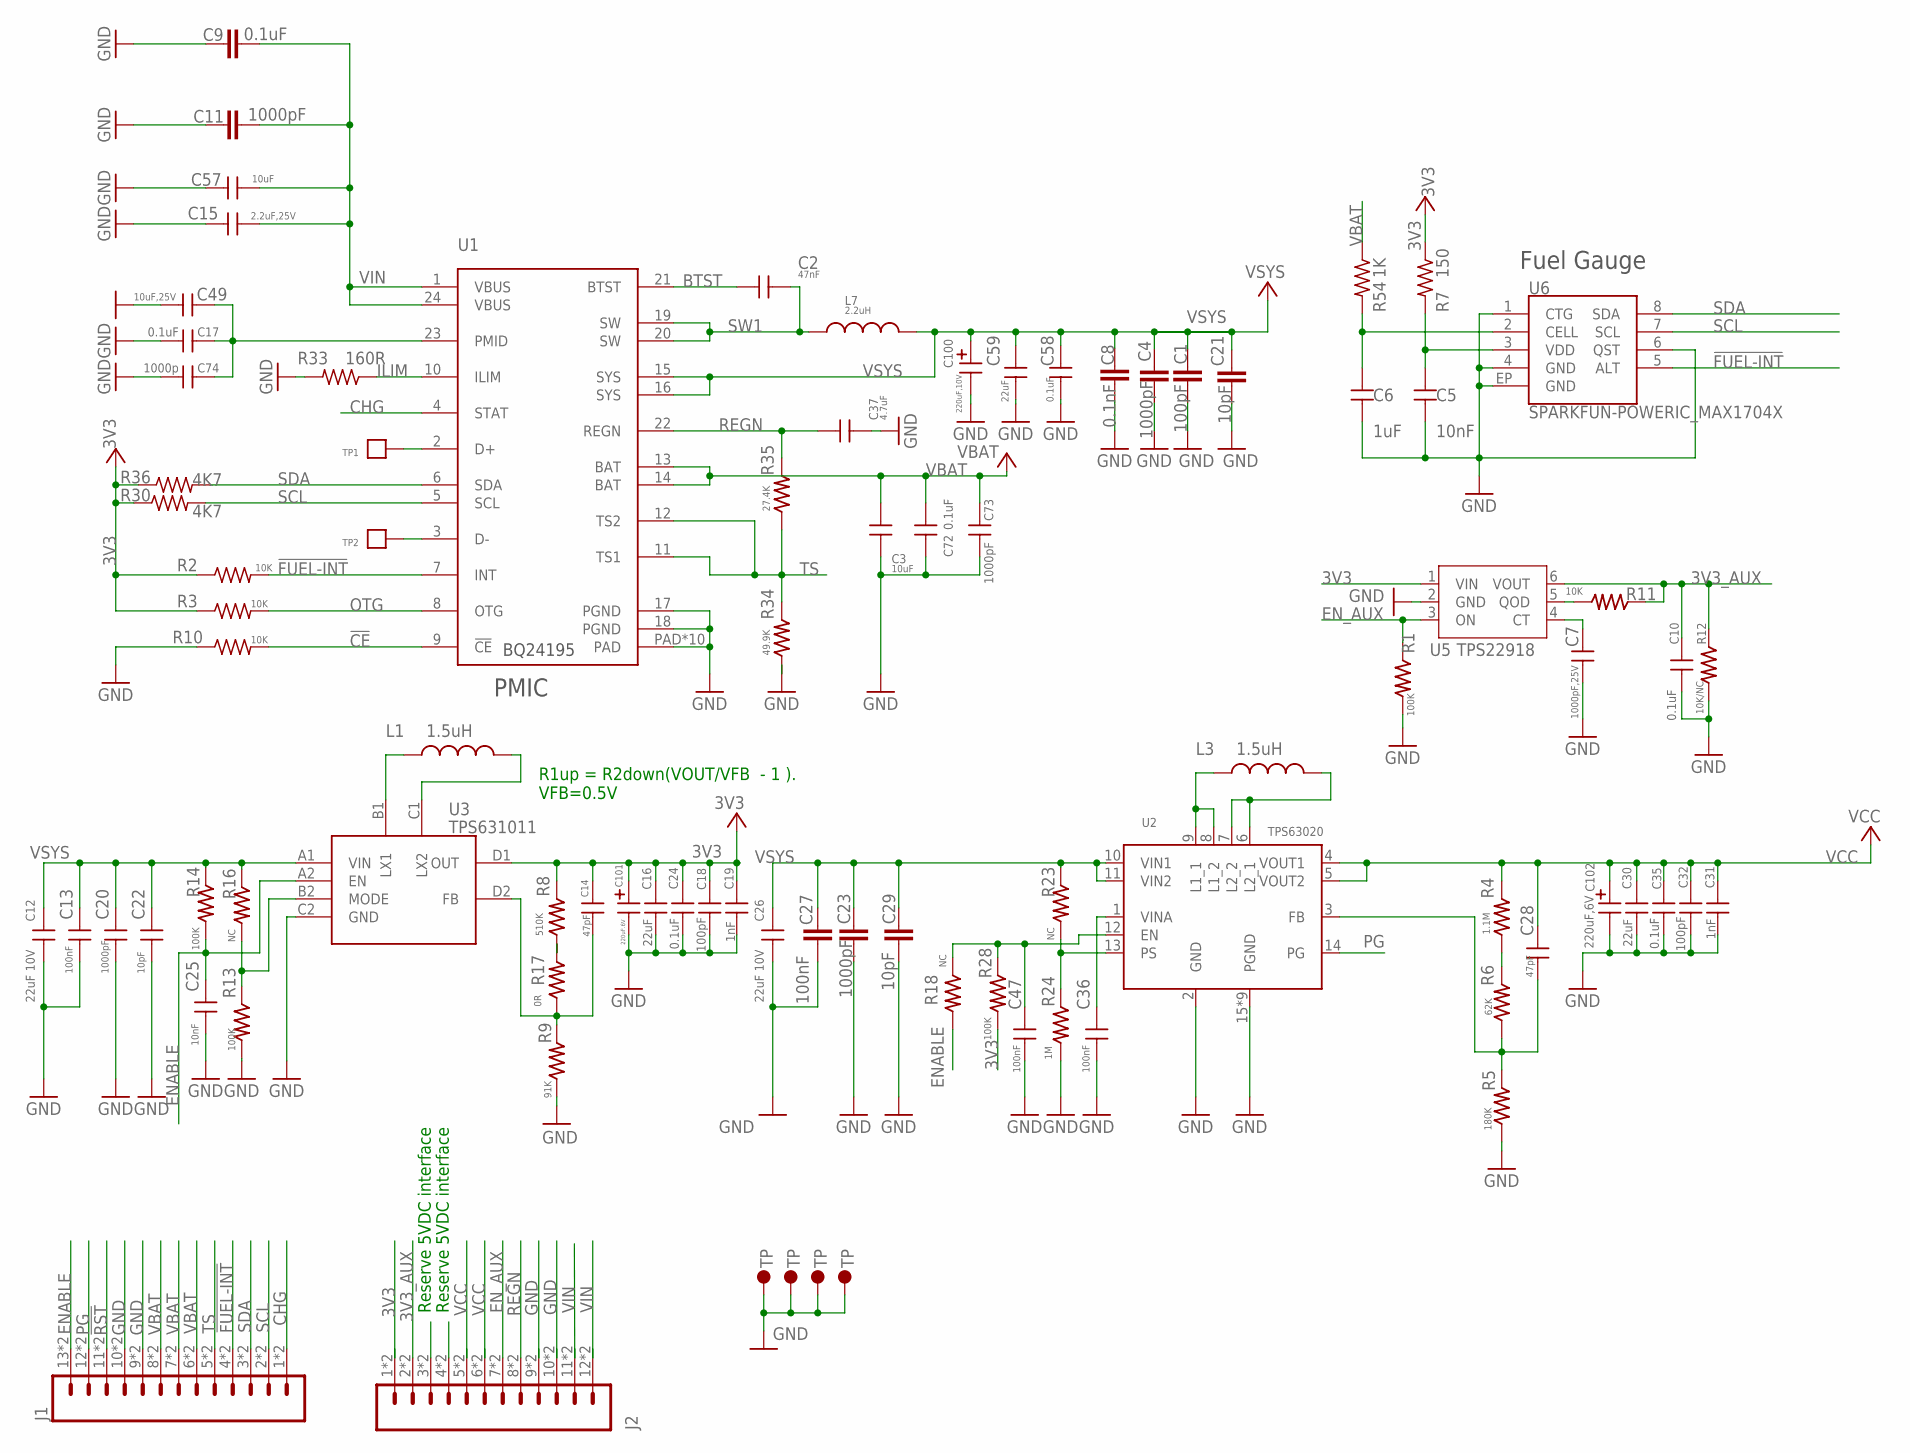
[picture p26: schematic PM-BAT v1.0-35X22.86.sch]

Parts:
C1: 100pF; C0402_B
C2: 47nF; C-0402
C3: 10uF; C0805
C4, C11, C23: 1000pF; C0402_B
C5: 10nF; C0402
C6: 1uF; C0402
C7: 1000pF,25V; C0402
C8: 0.1nF; C0402_B
C9: 0.1uF; C0402_B
C10: 0.1uF; C0201-N
C12, C26: 22uF 10V; C0603
C13, C36, C47: 100nF; C0201-N
C14, C28: 47pF; C0201-N
C15: 2.2uF,25V; C-0603A
C16, C30: 22uF; C-0603A
C17, C24, C35, C58: 0.1uF; C0402
C18, C32: 100pF; C0402
C19, C31: 1nF; C0402
C20: 1000pF; C0201-N
C21, C29: 10pF; C0402_B
C22: 10pF; C0201-N
C25: 10nF; C0201-N
C27: 100nF; C0402_B
C37: 4.7uF; C0402
C49: 10uF,25V; C-0603A
C57: 10uF; C-0603A
C59: 22uF; C0603
C72: 0.1uF; C-0402
C73: 1000pF; C-0402
C74: 1000p; C-0402
C100: 220uF,10V; CASE-B
C101: 220uF.6V; CASE-B
C102: 220uF,6V; CASE-B
J1: M13PTH-CST-R; 1X13-CASTELLATED
J2: M12PTH-CST-R; 1X12-CASTELLATED
L1, L3: 1.5uH; INDUCTOR-2520
L7: 2.2uH; INDUCTOR-4040
R1, R13, R14, R28: 100K; R0201-N
R2, R3, R10: 10K; R0402_B
R4: 1.1M; R0201-N
R5: 180K; R0201-N
R6: 62K; R0201-N
R7: 150; R0402_B
R8: 510K; R0201-N
R9: 91K; R0201-N
R11: 10K; R0201-N
R12: 10K/NC; R0201-N
R16, R18, R23: NC; R0201-N
R17: 0R; R0201-N
R24: 1M; R0201-N
R30, R36: 4K7; R0402_B
R33: 160R; R0402_B
R34: 49.9K; R0201-N
R35: 27.4K; R0201-N
R54: 1K; R0402_B
TP1, TP2: TP1311MM; TP-1311MM
U1: BQ24195; ELECTRON_QFN24
U2: TPS63020
U3: TPS631011; DSBGA
U5: TPS22918; SOT-23-6
U6: SPARKFUN-POWERIC_MAX1704X; SPARKFUN-POWERIC_TDFN-8
U$1, U$2, U$4, U$5: TP; TP_2.33X1.37

Connections:
3V3: C14.1, C16.1, C18.1, C19.1, C24.1, C101.P$1 (1), J2.1, J2.@1 (1), R2.1, R3.1, R7.1, R8.2, R28.2, R30.1, R36.1, U3.D1 (OUT), U5.1 (VIN)
3V3_AUX: C10.1, J2.2, J2.@2 (2), R11.1, R12.1, U5.6 (VOUT)
!CE: R10.2, U1.9 (!CE)
!FUEL-INT: J1.4, J1.@4 (4), R2.2, U1.7 (INT), U6.5 (ALT)
!RST: J1.11, J1.@11 (11)
BTST: C2.1, U1.21 (BTST)
CHG: J1.1, J1.@1 (1), U1.4 (STAT)
ENABLE: C25.1, J1.13, J1.@13 (13), R14.2, R18.2, U3.A2 (EN)
EN_AUX: J2.7, J2.@7 (7), R1.1, U5.3 (ON)
GND: C1.1, C3.2, C4.1, C5.2, C6.2, C7.2, C8.1, C9.1, C10.2, C11.1, C12.2, C13.2, C15.2, C16.2, C17.1, C18.2, C19.2, C20.2, C21.1, C22.2, C23.1, C24.2, C25.2, C26.2, C27.1, C29.1, C30.2, C31.2, C32.2, C35.2, C36.2, C37.2, C47.2, C49.2, C57.2, C58.2, C59.2, C72.2, C73.2, C74.1, C100.P$2 (2), C101.P$2 (2), C102.P$2 (2), J1.9, J1.10, J1.@9 (9), J1.@10 (10), J2.9, J2.10, J2.@9 (9), J2.@10 (10), R1.2, R5.1, R9.1, R10.1, R12.2, R13.2, R24.2, R33.2, R34.1, U1.17 (PGND), U1.18 (PGND), U1.PAD, U1.PAD@1 (PAD), U1.PAD@2 (PAD), U1.PAD@3 (PAD), U1.PAD@4 (PAD), U1.PAD@5 (PAD), U1.PAD@6 (PAD), U1.PAD@7 (PAD), U1.PAD@8 (PAD), U1.PAD@9 (PAD), U2.2 (GND), U2.15 (PGND), U2.16 (PGND), U2.17 (PGND), U2.18 (PGND), U2.19 (PGND), U2.20 (PGND), U2.21 (PGND), U2.22 (PGND), U2.23 (PGND), U3.C2 (GND), U5.2 (GND), U6.1 (CTG), U6.4 (GND), U6.6 (QST), U6.EP (GND), U$1.1, U$2.1, U$4.1, U$5.1
ILIM: R33.1, U1.10 (ILIM)
unnamed: J2.3, J2.@3 (3)
unnamed: C17.2, C49.1, C74.2, U1.23 (PMID)
unnamed: TP2.P$1, U1.3 (D-)
unnamed: C14.2, R9.2, R17.1, U3.D2 (FB)
unnamed: C28.2, R5.2, R6.1, U2.3 (FB)
unnamed: TP1.P$1, U1.2 (D+)
unnamed: R8.1, R17.2
unnamed: R4.1, R6.2
unnamed: J2.4, J2.@4 (4)
unnamed: L3.1, U2.8 (L1_2), U2.9 (L1_1)
unnamed: L1.1, U3.B1 (LX1)
unnamed: R13.1, R16.2, U3.B2 (MODE)
unnamed: L3.2, U2.6 (L2_1), U2.7 (L2_2)
unnamed: L1.2, U3.C1 (LX2)
unnamed: C7.1, U5.4 (CT)
unnamed: C36.1, U2.1 (VINA)
unnamed: R11.2, U5.5 (QOD)
unnamed: C47.1, R18.1, R28.1, U2.12 (EN)
unnamed: R23.2, R24.1, U2.13 (PS)
unnamed: C5.1, R7.2, U6.3 (VDD)
unnamed: C6.1, R54.2, U6.2 (CELL)
OTG: R3.2, U1.8 (OTG)
PG: J1.12, J1.@12 (12), U2.14 (PG)
REGN: C37.1, J2.8, J2.@8 (8), R35.2, U1.22 (REGN)
SCL: J1.2, J1.@2 (2), R30.2, U1.5 (SCL), U6.7 (SCL)
SDA: J1.3, J1.@3 (3), R36.2, U1.6 (SDA), U6.8 (SDA)
SW1: C2.2, L7.P$1 (1), U1.19 (SW), U1.20 (SW)
TS: J1.5, J1.@5 (5), R34.2, R35.1, U1.11 (TS1), U1.12 (TS2)
VBAT: C3.1, C72.1, C73.1, J1.6, J1.7, J1.8, J1.@6 (6), J1.@7 (7), J1.@8 (8), R54.1, U1.13 (BAT), U1.14 (BAT)
VCC: C28.1, C30.1, C31.1, C32.1, C35.1, C102.P$1 (1), J2.5, J2.6, J2.@5 (5), J2.@6 (6), R4.2, U2.4 (VOUT1), U2.5 (VOUT2)
VIN: C9.2, C11.2, C15.1, C57.1, J2.11, J2.12, J2.@11 (11), J2.@12 (12), U1.1 (VBUS), U1.24 (VBUS)
VSYS: C1.2, C4.2, C8.2, C12.1, C13.1, C20.1, C21.2, C22.1, C23.2, C26.1, C27.2, C29.2, C58.1, C59.1, C100.P$1 (1), L7.P$2 (2), R14.1, R16.1, R23.1, U1.15 (SYS), U1.16 (SYS), U2.10 (VIN1), U2.11 (VIN2), U3.A1 (VIN)

Notes on the sheet:
PMIC
Fuel Gauge
R1up = R2down(VOUT/VFB - 1 ). VFB=0.5V
Reserve 5VDC interface

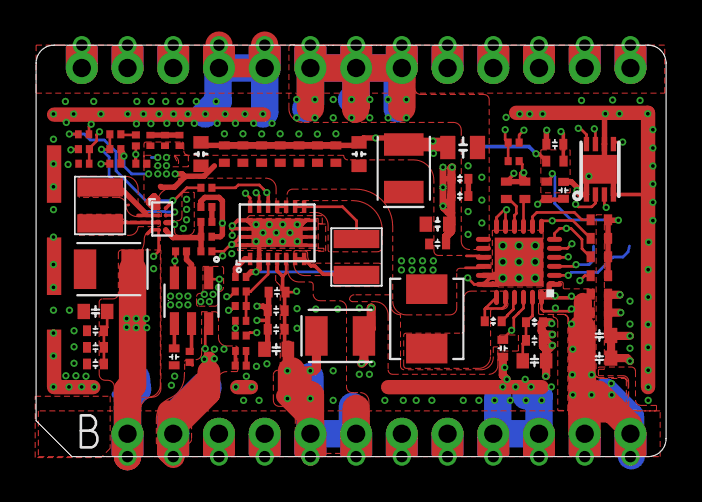
[picture p27: board PM-BAT v1.0-35X22.86.brd from above]

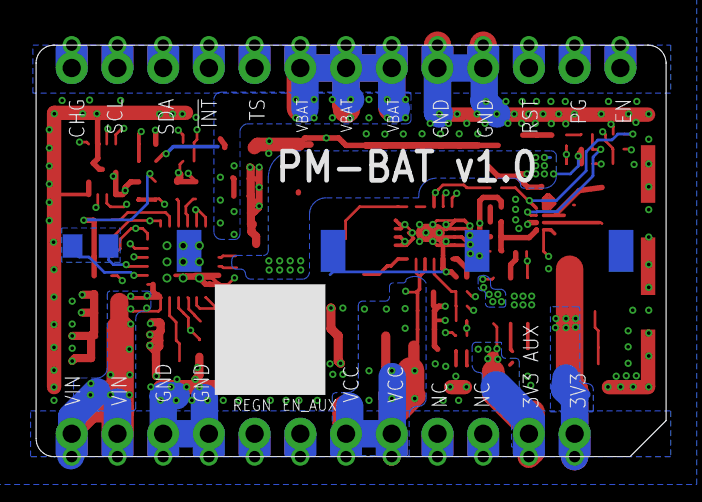
[picture p28: board PM-BAT v1.0-35X22.86.brd from below]

Board: 4 copper layers, 35.0 x 22.9 mm, 88 parts (6 on the bottom side), 43 nets.
