particle-iot/power-module/PM-DC/V0.1/ELEKTRA-BENCH v0.1-20240103.brd

## EAGLE design PM-DC/V0.1/ELEKTRA-BENCH v0.1-20240103.brd (2024-02-01, an earlier design)

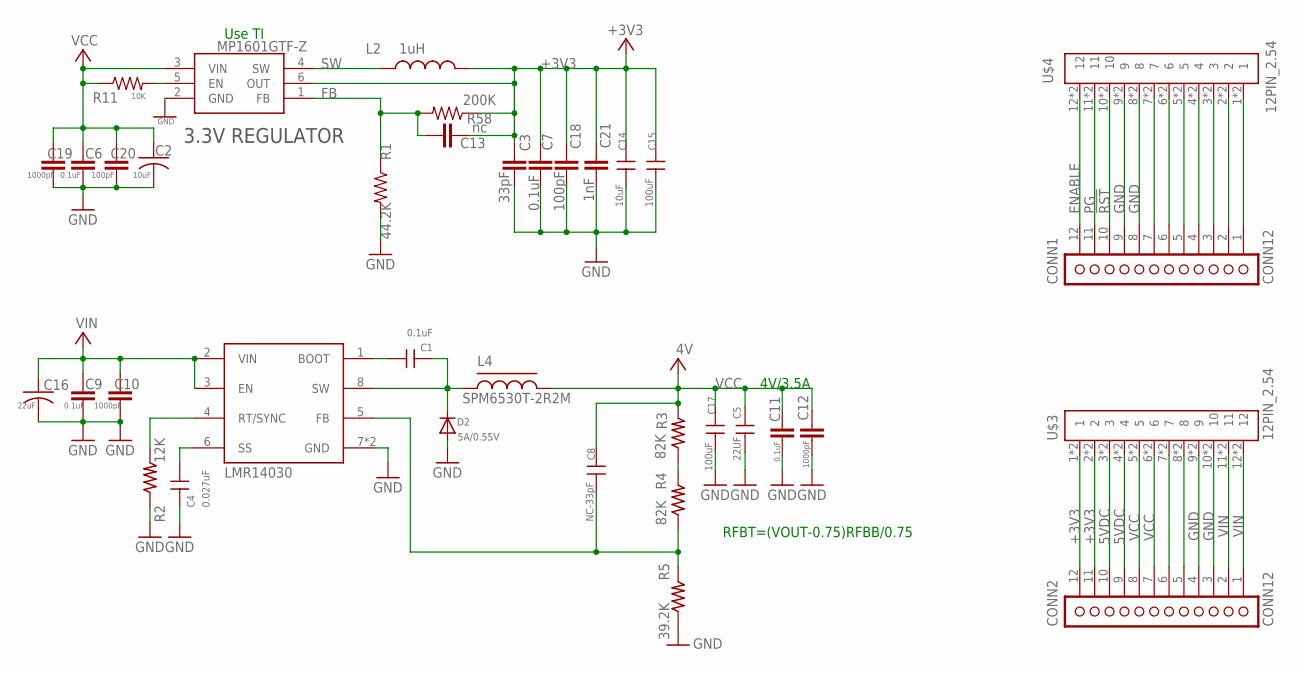
[picture p29: schematic ELEKTRA-BENCH v0.1-20240103.sch]

Parts:
C1: 0.1uF; C0402
C2: 10uF; C0603_B
C3: 33pF; C0402_B
C4: 0.027uF; C0402
C5: 22UF; C0805
C6, C7, C9, C11: 0.1uF; C0402_B
C8: NC-33pF; C0402
C10, C12, C19: 1000pF; C0402_B
C13: nc; C0402_B
C14: 10uF; C0805
C15, C17: 100uF; C1206
C16: 22uF; C0603_B
C18, C20: 100pF; C0402_B
C21: 1nF; C0402_B
CONN1, CONN2: CONN12; 1X12_SMD_STRAIGHT
D2: 5A/0.55V; SMADIODE
L2: 1uH; INDUCTOR-VLS-E
L4: SPM6530T-2R2M; INDCUTOR_SPM6530
R1: 44.2K; R0402_B
R2: 12K; R-0402S
R3, R4: 82K; R-0402S
R5: 39.2K; R-0402S
R11: 10K; R0402_B
R58: 200K; R0402_B
U2: LMR14030; SO_POWERPAD_8
U3: MP1601GTF-Z; SOTFL50P160X60-6N
U$3, U$4: 12PIN_2.54

Connections:
5VDC: CONN2.9, CONN2.10, U$3.3, U$3.4, U$3.P$3 (3), U$3.P$4 (4)
!RST: CONN1.10, U$4.10, U$4.P$10 (10)
+3V3: C3.2, C7.2, C13.1, C14.1, C15.1, C18.2, C21.2, CONN2.11, CONN2.12, L2.P$2 (2), R58.1, U3.6 (OUT), U$3.1, U$3.2, U$3.P$1 (1), U$3.P$2 (2)
ENABLE: CONN1.12, U$4.12, U$4.P$12 (12)
FB: C13.2, R1.1, R58.2, U3.1 (FB)
GND: C2.2, C3.1, C4.2, C5.2, C6.1, C7.1, C9.1, C10.1, C11.1, C12.1, C14.2, C15.2, C16.2, C17.2, C18.1, C19.1, C20.1, C21.1, CONN1.8, CONN1.9, CONN2.3, CONN2.4, D2.A, R1.2, R2.1, R5.1, U2.7 (GND), U2.EP (GND), U3.2 (GND), U$3.9, U$3.10, U$3.P$9 (9), U$3.P$10 (10), U$4.8, U$4.9, U$4.P$8 (8), U$4.P$9 (9)
unnamed: C8.1, R4.1, R5.2, U2.5 (FB)
unnamed: CONN1.7, U$4.7, U$4.P$7 (7)
unnamed: CONN1.6, U$4.6, U$4.P$6 (6)
unnamed: CONN1.5, U$4.5, U$4.P$5 (5)
unnamed: CONN1.4, U$4.4, U$4.P$4 (4)
unnamed: R11.2, U3.5 (EN)
unnamed: C4.1, U2.6 (SS)
unnamed: C1.2, D2.C, L4.1, U2.8 (SW)
unnamed: C1.1, U2.1 (BOOT)
unnamed: R2.2, U2.4 (RT/SYNC)
unnamed: R3.1, R4.2
unnamed: CONN1.3, U$4.3, U$4.P$3 (3)
unnamed: CONN1.2, U$4.2, U$4.P$2 (2)
unnamed: CONN1.1, U$4.1, U$4.P$1 (1)
unnamed: CONN2.6, U$3.7, U$3.P$7 (7)
unnamed: CONN2.5, U$3.8, U$3.P$8 (8)
PG: CONN1.11, U$4.11, U$4.P$11 (11)
SW: L2.P$1 (1), U3.4 (SW)
VCC: C2.1, C5.1, C6.2, C8.2, C11.2, C12.2, C17.1, C19.2, C20.2, CONN2.7, CONN2.8, L4.2, R3.2, R11.1, U3.3 (VIN), U$3.5, U$3.6, U$3.P$5 (5), U$3.P$6 (6)
VIN: C9.2, C10.2, C16.1, CONN2.1, CONN2.2, U2.2 (VIN), U2.3 (EN), U$3.11, U$3.12, U$3.P$11 (11), U$3.P$12 (12)

Notes on the sheet:
4V/3.5A
3.3V REGULATOR
RFBT=(VOUT-0.75)RFBB/0.75
Use TI

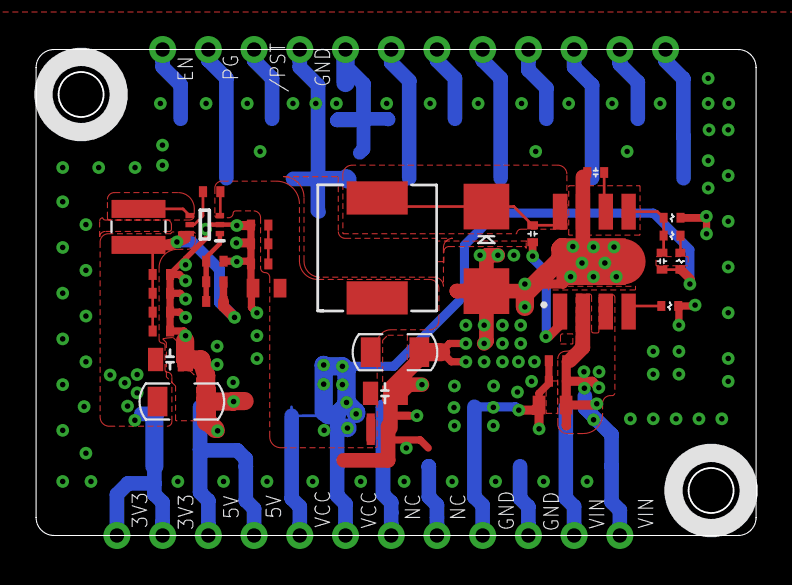
[picture p30: board ELEKTRA-BENCH v0.1-20240103.brd from above]

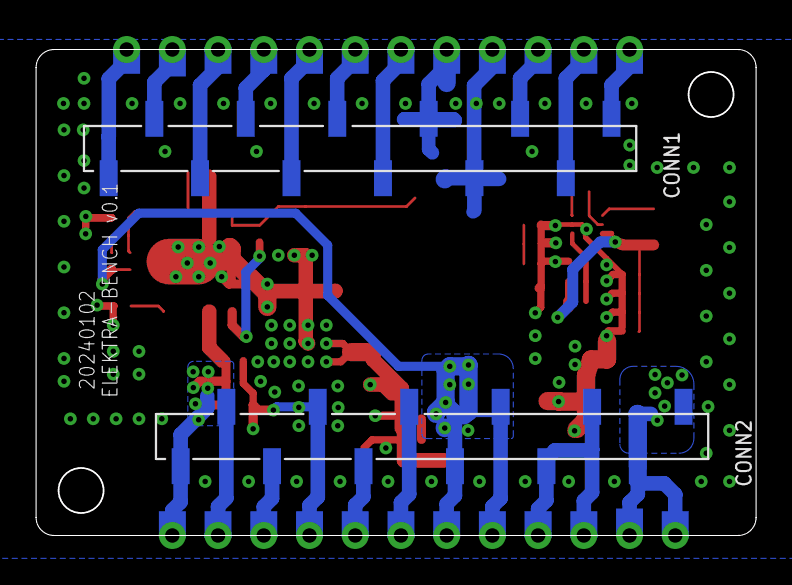
[picture p31: board ELEKTRA-BENCH v0.1-20240103.brd from below]

Board: 2 copper layers, 40.0 x 27.0 mm, 37 parts (2 on the bottom side), 26 nets.
