particle-iot/power-module/PowerModule_TestBoard/eagle/powerModule_v0.0.3/PowerModule_Testboard_v0.0.3.brd

## EAGLE design PowerModule_TestBoard/eagle/powerModule_v0.0.3/PowerModule_Testboard_v0.0.3.brd (2024-05-15)

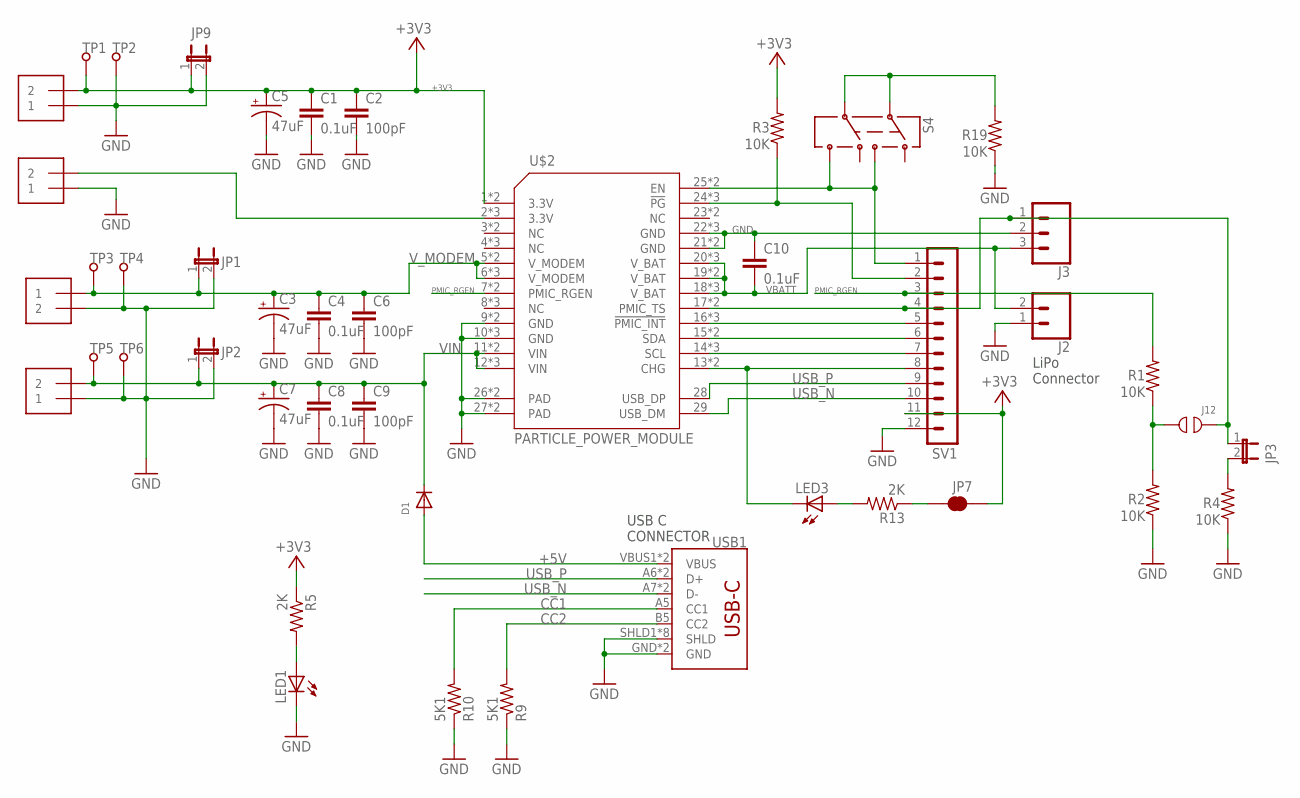
[picture p32: schematic PowerModule_Testboard_v0.0.3.sch]

Parts:
C1, C4, C8, C10: 0.1uF; 0603
C2, C6, C9: 100pF; 0603
C3, C5, C7: 47uF; NIC_10X10.5_CAP
D1: DIODE_SOD-123FL; SOD-123FL
J1, J4, J5, J6: 1X2-3.5MM
J2: CONN_02-JST-2MM-SMT; JST-2-SMD@2
J3: CONN_03JST-SMD-VERT; JST-3-SMD-VERT
J12: TP_OPEN
JP1, JP2, JP3, JP9: JUMPER2
JP7: JUMPER-SMT_2_NC_TRACE_NO-SILK; SMT-JUMPER_2_NC_TRACE_NO-SILK
LED1, LED3: LEDCHIP-LED0603; CHIP-LED0603
R1, R2, R3, R4, R19: 10K; R0603_P
R5, R13: 2K; R0603_P
R9, R10: 5K1; R0603_P
S4: SWITCH-DPDT; SWITCH-2.5X3.2-6
SV1: MA12-1
TP1, TP2, TP3, TP4, TP5, TP6: TP-S2751-46R; S2751-46R
U$2: PARTICLE_POWER_MODULE
USB1: USB_C16PIN; USB-C-16P

Connections:
+3V3: C1.1, C2.1, C5.+, J4.2, JP7.1, JP9.1, R3.2, R5.1, SV1.11, TP1.1, U$2.1 (3.3V), U$2.1@1 (3.3V)
+5V: D1.A, USB1.VBUS1 (VBUS), USB1.VBUS2 (VBUS)
CC1: R10.2, USB1.A5 (CC1)
CC2: R9.2, USB1.B5 (CC2)
GND: C1.2, C2.2, C3.-, C4.2, C5.-, C6.2, C7.-, C8.2, C9.2, C10.1, J1.2, J2.1 (2), J3.2, J4.1, J5.1, J6.1, JP1.2, JP2.2, JP9.2, LED1.C, R2.1, R4.1, R9.1, R10.1, R19.1, SV1.12, TP2.1, TP4.1, TP6.1, U$2.9 (GND), U$2.9@1 (GND), U$2.10 (GND), U$2.10@1 (GND), U$2.10@2 (GND), U$2.21 (GND), U$2.21@1 (GND), U$2.22 (GND), U$2.22@1 (GND), U$2.22@2 (GND), U$2.26 (PAD), U$2.26@1 (PAD), U$2.27 (PAD), U$2.27@2 (PAD), USB1.GND, USB1.GND2 (GND), USB1.SHLD1 (SHLD), USB1.SHLD2 (SHLD), USB1.SHLD3 (SHLD), USB1.SHLD4 (SHLD), USB1.SHLD5 (SHLD), USB1.SHLD6 (SHLD), USB1.SHLD7 (SHLD), USB1.SHLD8 (SHLD)
unnamed: JP7.2, R13.1
unnamed: R19.2, S4.2, S4.5
unnamed: J12.1, R1.1, R2.2
unnamed: R3.1, SV1.2, U$2.24 (!PG), U$2.24@1 (!PG), U$2.24@2 (!PG)
unnamed: J3.1, J12.2, JP3.1, SV1.4, U$2.17 (PMIC_TS), U$2.17@1 (PMIC_TS)
unnamed: SV1.5, U$2.16 (!PMIC_INT), U$2.16@1 (!PMIC_INT), U$2.16@2 (!PMIC_INT)
unnamed: SV1.6, U$2.15 (SDA), U$2.15@1 (SDA)
unnamed: SV1.7, U$2.14 (SCL), U$2.14@1 (SCL), U$2.14@2 (SCL)
unnamed: JP3.2, R4.2
unnamed: LED3.C, SV1.8, U$2.13 (CHG), U$2.13@1 (CHG)
unnamed: LED3.A, R13.2
unnamed: S4.3, S4.6, SV1.1, U$2.25 (EN), U$2.25@1 (EN)
unnamed: J6.2, U$2.2 (3.3V), U$2.2@1 (3.3V), U$2.2@2 (3.3V)
unnamed: LED1.A, R5.2
PMIC_RGEN: R1.2, SV1.3, U$2.7 (PMIC_RGEN), U$2.7@1 (PMIC_RGEN)
USB_N: SV1.10, U$2.29 (USB_DM), USB1.A7 (D-), USB1.B7 (D-)
USB_P: SV1.9, U$2.28 (USB_DP), USB1.A6 (D+), USB1.B6 (D+)
VBATT: C10.2, J2.2 (1), J3.3, U$2.18 (V_BAT), U$2.18@1 (V_BAT), U$2.18@2 (V_BAT), U$2.19 (V_BAT), U$2.19@1 (V_BAT), U$2.20 (V_BAT), U$2.20@1 (V_BAT), U$2.20@2 (V_BAT)
VIN: C7.+, C8.1, C9.1, D1.C, J5.2, JP2.1, TP5.1, U$2.11 (VIN), U$2.11@1 (VIN), U$2.12 (VIN), U$2.12@1 (VIN), U$2.12@2 (VIN)
V_MODEM: C3.+, C4.1, C6.1, J1.1, JP1.1, TP3.1, U$2.5 (V_MODEM), U$2.5@1 (V_MODEM), U$2.6 (V_MODEM), U$2.6@1 (V_MODEM), U$2.6@2 (V_MODEM)

Notes on the sheet:
USB C CONNECTOR
LiPo Connector

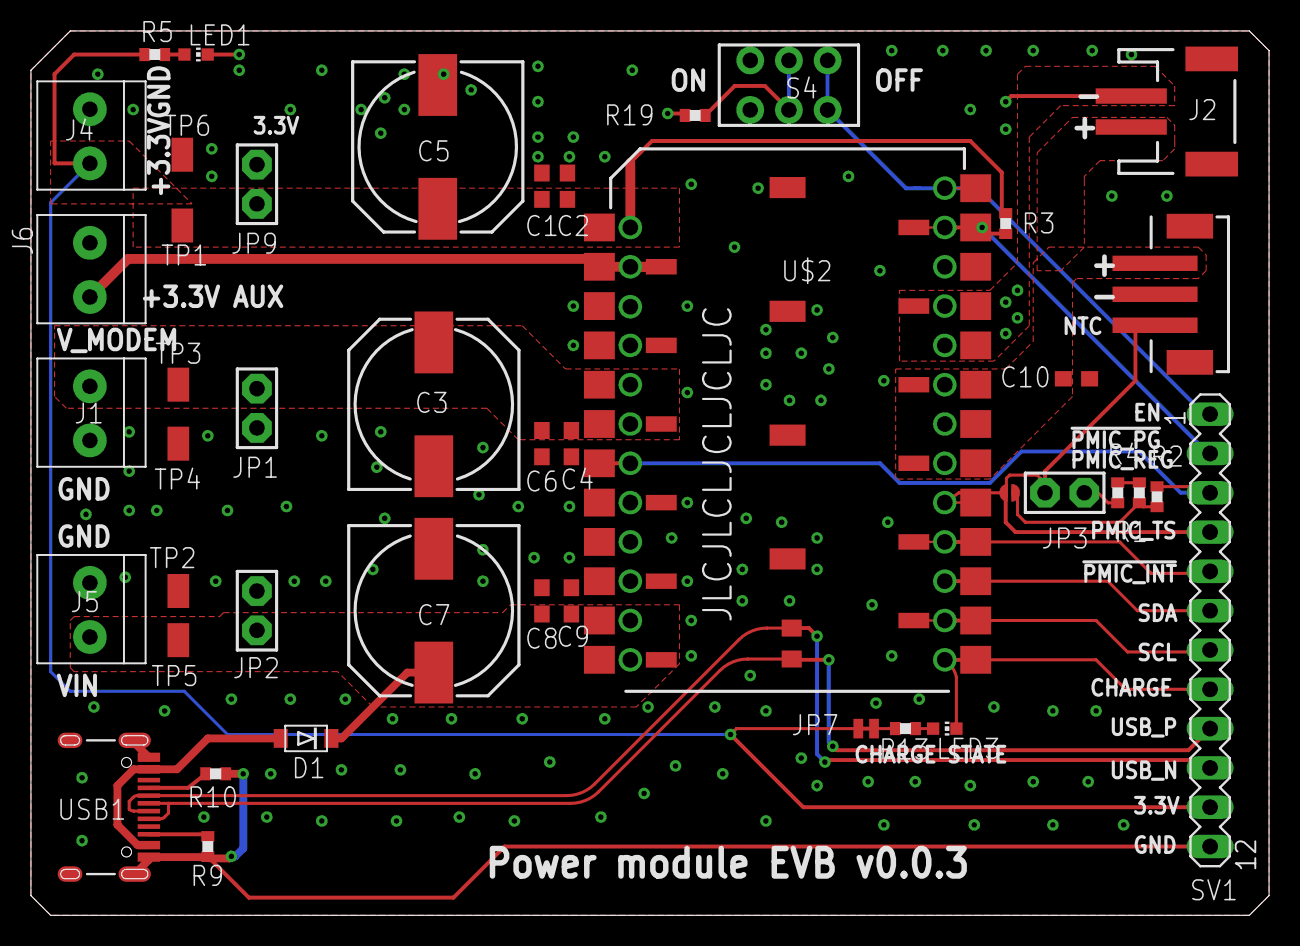
[picture p33: board PowerModule_Testboard_v0.0.3.brd from above]

Board: 2 copper layers, 80.0 x 57.1 mm, 44 parts (0 on the bottom side), 25 nets.
