particle-iot/power-module/PM-BAT/V0.1/PM-BAT/v0.2-layout/ELEKTRA-PMIC v0.2-35X22.86-0.8.brd

## EAGLE design PM-BAT/V0.1/PM-BAT/v0.2-layout/ELEKTRA-PMIC v0.2-35X22.86-0.8.brd (2024-03-11, an earlier design)

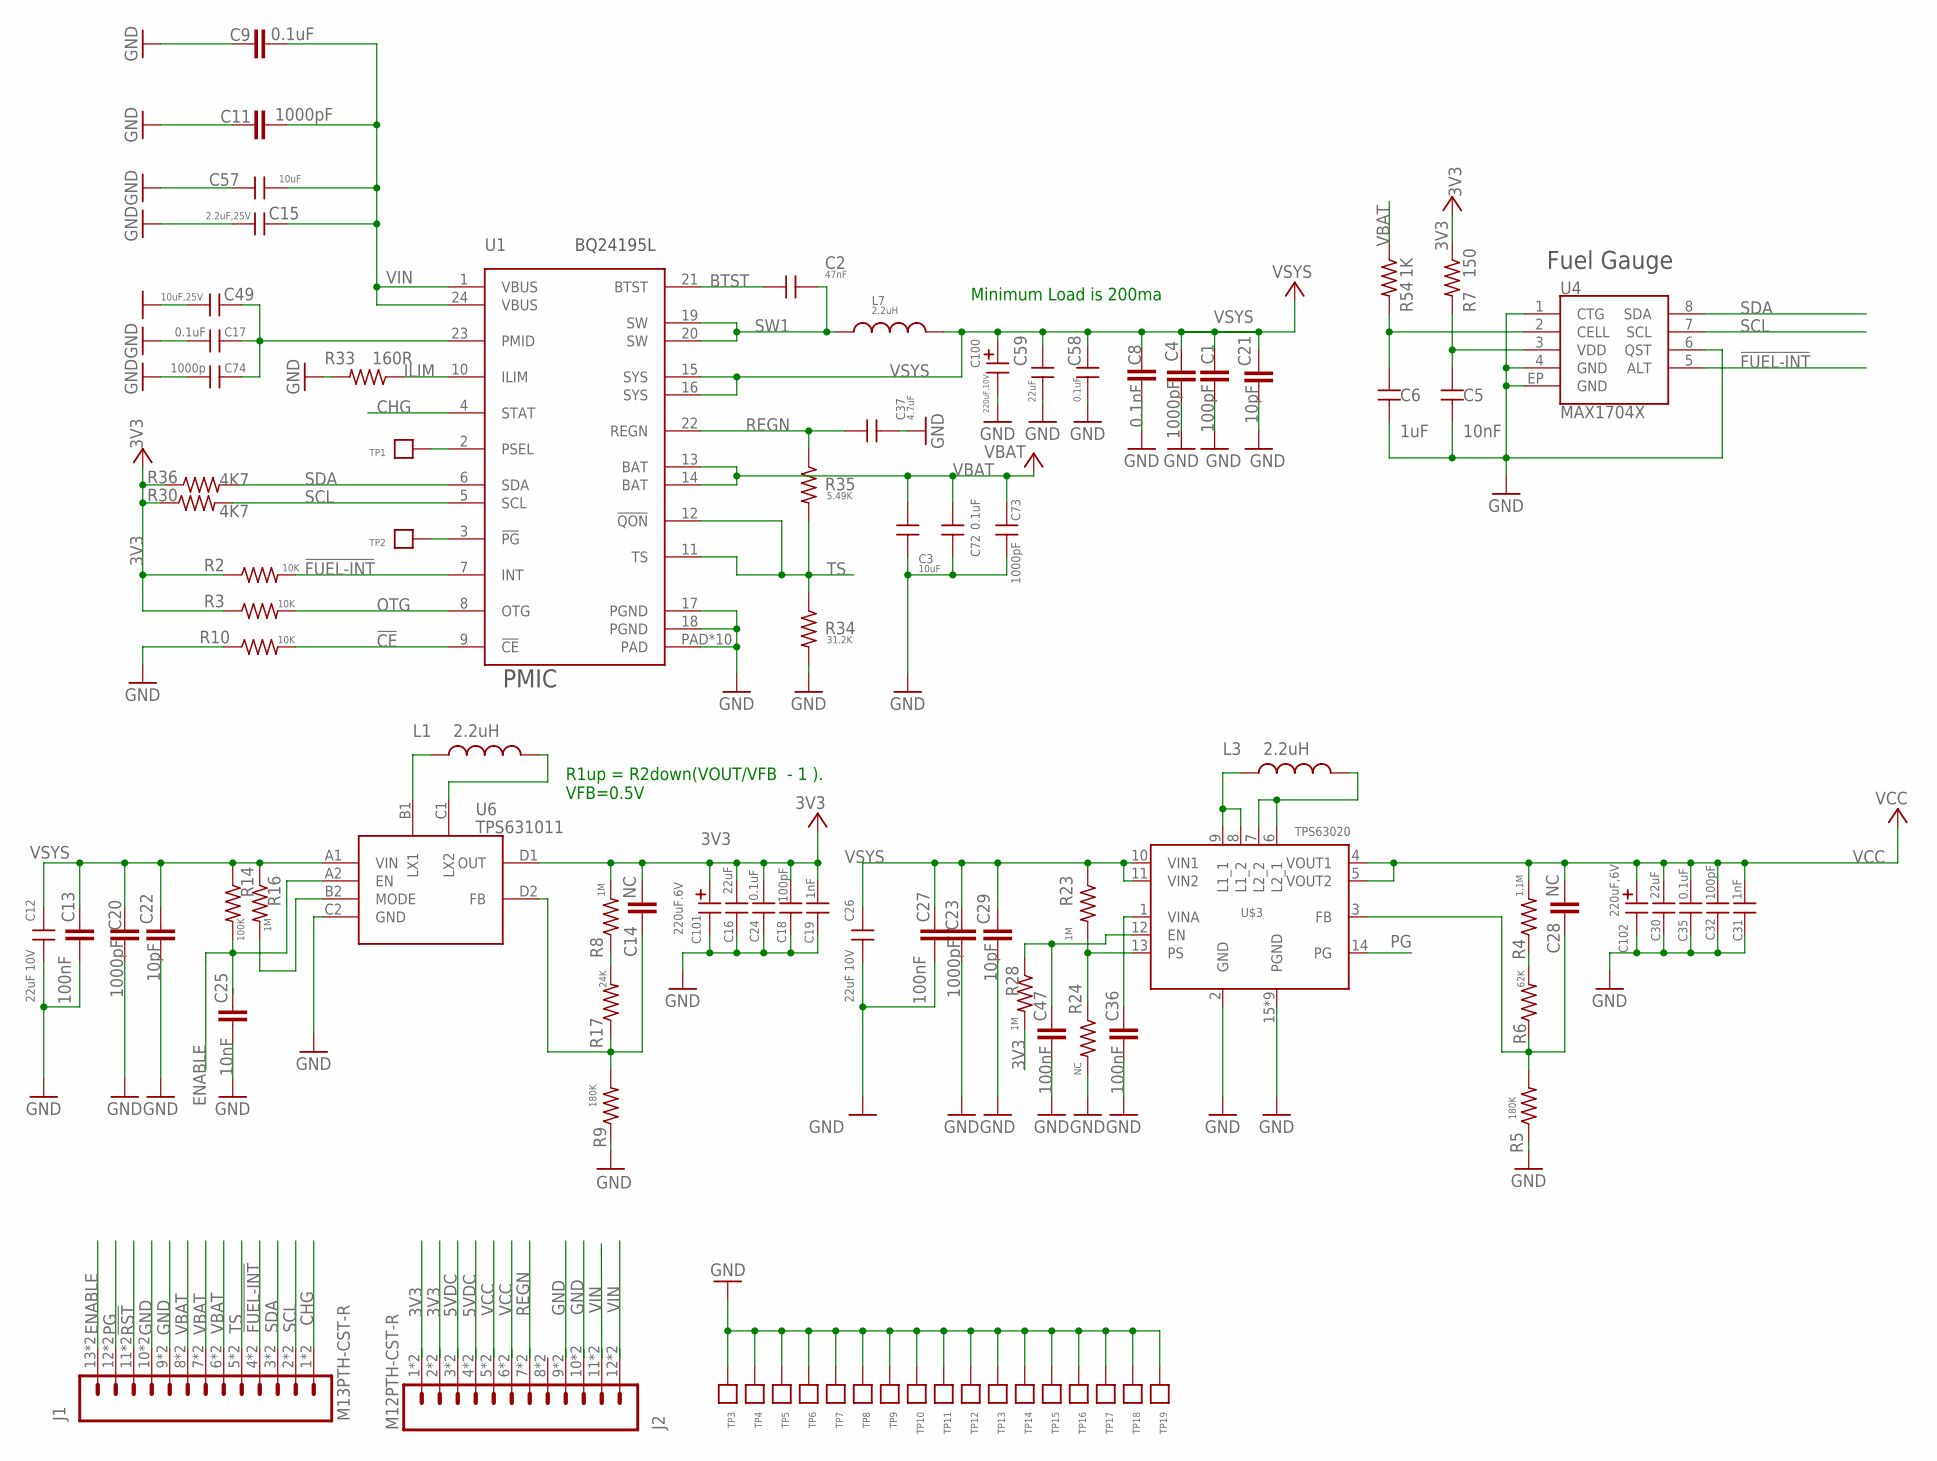
[picture p34: schematic ELEKTRA-PMIC v0.2-35X22.86-0.8.sch]

Parts:
C1: 100pF; C0402_B
C2: 47nF; C-0402
C3: 10uF; C0805
C4, C11, C20, C23: 1000pF; C0402_B
C5: 10nF; C0402
C6: 1uF; C0402
C8: 0.1nF; C0402_B
C9: 0.1uF; C0402_B
C12, C26: 22uF 10V; C0805
C13, C27, C36, C47: 100nF; C0402_B
C14, C28: NC; C0402_B
C15: 2.2uF,25V; C-0603A
C16, C30: 22uF; C-0603A
C17, C24, C35, C58: 0.1uF; C0402
C18, C32: 100pF; C0402
C19, C31: 1nF; C0402
C21, C22, C29: 10pF; C0402_B
C25: 10nF; C0402_B
C37: 4.7uF; C0402
C49: 10uF,25V; C-0603A
C57: 10uF; C-0603A
C59: 22uF; C0603
C72: 0.1uF; C-0402
C73: 1000pF; C-0402
C74: 1000p; C-0402
C100: 220uF,10V; CASE-B
C101: 220uF.6V; CASE-B
C102: 220uF,6V; CASE-B
J1: M13PTH-CST-R; 1X13-CASTELLATED
J2: M12PTH-CST-R; 1X12-CASTELLATED
L1, L3: 2.2uH; INDUCTOR-VLS-E
L7: 2.2uH; INDUCTOR-4040
R2, R3, R10: 10K; R0402_B
R4: 1.1M; R0402_B
R5, R9: 180K; R0402_B
R6: 62K; R0402_B
R7: 150; R0402_B
R8, R16, R23, R28: 1M; R0402_B
R14: 100K; R0402_B
R17: 24K; R0402_B
R24: NC; R0402_B
R30, R36: 4K7; R0402_B
R33: 160R; R0402_B
R34: 31.2K; R0402_B
R35: 5.49K; R0402_B
R54: 1K; R0402_B
TP1, TP2: TP1311MM; TP-1311MM
TP3, TP4, TP5, TP6, TP7, TP8, TP9, TP10, TP11, TP12, TP13, TP14, TP15, TP16, TP17, TP18, TP19: TP0.4MM
U1: BQ24195L; QFN24
U4: MAX1704X; TDFN-8
U6: TPS631011; DSBGA
U$3: TPS63020

Connections:
3V3: C14.2, C16.1, C18.1, C19.1, C24.1, C101.P$1 (1), J2.1, J2.2, J2.@1 (1), J2.@2 (2), R2.1, R3.1, R7.1, R8.2, R28.2, R30.1, R36.1, U6.D1 (OUT)
5VDC: J2.3, J2.4, J2.@3 (3), J2.@4 (4)
!CE: R10.2, U1.9 (!CE)
!FUEL-INT: J1.4, J1.@4 (4), R2.2, U1.7 (INT), U4.5 (ALT)
!RST: J1.11, J1.@11 (11)
BTST: C2.1, U1.21 (BTST)
CHG: J1.1, J1.@1 (1), U1.4 (STAT)
ENABLE: C25.2, J1.13, J1.@13 (13), R14.2, U6.A2 (EN)
GND: C1.1, C3.2, C4.1, C5.2, C6.2, C8.1, C9.1, C11.1, C12.2, C13.1, C15.2, C16.2, C17.1, C18.2, C19.2, C20.1, C21.1, C22.1, C23.1, C24.2, C25.1, C26.2, C27.1, C29.1, C30.2, C31.2, C32.2, C35.2, C36.1, C37.2, C47.1, C49.2, C57.2, C58.2, C59.2, C72.2, C73.2, C74.1, C100.P$2 (2), C101.P$2 (2), C102.P$2 (2), J1.9, J1.10, J1.@9 (9), J1.@10 (10), J2.9, J2.10, J2.@9 (9), J2.@10 (10), R5.1, R9.1, R10.1, R24.2, R33.2, R34.2, TP3.P$1, TP4.P$1, TP5.P$1, TP6.P$1, TP7.P$1, TP8.P$1, TP9.P$1, TP10.P$1, TP11.P$1, TP12.P$1, TP13.P$1, TP14.P$1, TP15.P$1, TP16.P$1, TP17.P$1, TP18.P$1, TP19.P$1, U1.17 (PGND), U1.18 (PGND), U1.PAD, U1.PAD@1 (PAD), U1.PAD@2 (PAD), U1.PAD@3 (PAD), U1.PAD@4 (PAD), U1.PAD@5 (PAD), U1.PAD@6 (PAD), U1.PAD@7 (PAD), U1.PAD@8 (PAD), U1.PAD@9 (PAD), U4.1 (CTG), U4.4 (GND), U4.6 (QST), U4.EP (GND), U6.C2 (GND), U$3.2 (GND), U$3.15 (PGND), U$3.16 (PGND), U$3.17 (PGND), U$3.18 (PGND), U$3.19 (PGND), U$3.20 (PGND), U$3.21 (PGND), U$3.22 (PGND), U$3.23 (PGND)
ILIM: R33.1, U1.10 (ILIM)
unnamed: C17.2, C49.1, C74.2, U1.23 (PMID)
unnamed: TP2.P$1, U1.3 (!PG)
unnamed: C14.1, R9.2, R17.1, U6.D2 (FB)
unnamed: C28.1, R5.2, R6.1, U$3.3 (FB)
unnamed: TP1.P$1, U1.2 (PSEL)
unnamed: R8.1, R17.2
unnamed: R4.1, R6.2
unnamed: L3.P$1 (1), U$3.8 (L1_2), U$3.9 (L1_1)
unnamed: L1.P$1 (1), U6.B1 (LX1)
unnamed: R16.2, U6.B2 (MODE)
unnamed: L3.P$2 (2), U$3.6 (L2_1), U$3.7 (L2_2)
unnamed: L1.P$2 (2), U6.C1 (LX2)
unnamed: C36.2, U$3.1 (VINA)
unnamed: C47.2, R28.1, U$3.12 (EN)
unnamed: R23.2, R24.1, U$3.13 (PS)
unnamed: C5.1, R7.2, U4.3 (VDD)
unnamed: C6.1, R54.2, U4.2 (CELL)
OTG: R3.2, U1.8 (OTG)
PG: J1.12, J1.@12 (12), U$3.14 (PG)
REGN: C37.1, J2.7, J2.@7 (7), R35.1, U1.22 (REGN)
SCL: J1.2, J1.@2 (2), R30.2, U1.5 (SCL), U4.7 (SCL)
SDA: J1.3, J1.@3 (3), R36.2, U1.6 (SDA), U4.8 (SDA)
SW1: C2.2, L7.P$1 (1), U1.19 (SW), U1.20 (SW)
TS: J1.5, J1.@5 (5), R34.1, R35.2, U1.11 (TS), U1.12 (!QON)
VBAT: C3.1, C72.1, C73.1, J1.6, J1.7, J1.8, J1.@6 (6), J1.@7 (7), J1.@8 (8), R54.1, U1.13 (BAT), U1.14 (BAT)
VCC: C28.2, C30.1, C31.1, C32.1, C35.1, C102.P$1 (1), J2.5, J2.6, J2.@5 (5), J2.@6 (6), R4.2, U$3.4 (VOUT1), U$3.5 (VOUT2)
VIN: C9.2, C11.2, C15.1, C57.1, J2.11, J2.12, J2.@11 (11), J2.@12 (12), U1.1 (VBUS), U1.24 (VBUS)
VSYS: C1.2, C4.2, C8.2, C12.1, C13.2, C20.2, C21.2, C22.2, C23.2, C26.1, C27.2, C29.2, C58.1, C59.1, C100.P$1 (1), L7.P$2 (2), R14.1, R16.1, R23.1, U1.15 (SYS), U1.16 (SYS), U6.A1 (VIN), U$3.10 (VIN1), U$3.11 (VIN2)

Notes on the sheet:
Minimum Load is 200ma
PMIC
Fuel Gauge
R1up = R2down(VOUT/VFB - 1 ). VFB=0.5V
