particle-iot/power-module/PM-BAT/V0.1/PM-BAT/v0.2-layout/ELEKTRA-PMIC v0.2-35X22.86-0.8.brd

## EAGLE design PM-BAT/V0.1/PM-BAT/v0.2-layout/ELEKTRA-PMIC v0.2-35X22.86-0.8.brd (continued)

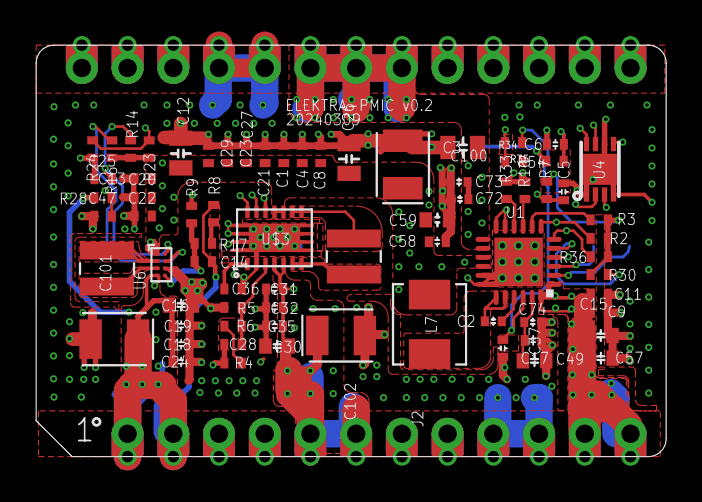
[picture p35: board ELEKTRA-PMIC v0.2-35X22.86-0.8.brd from above]

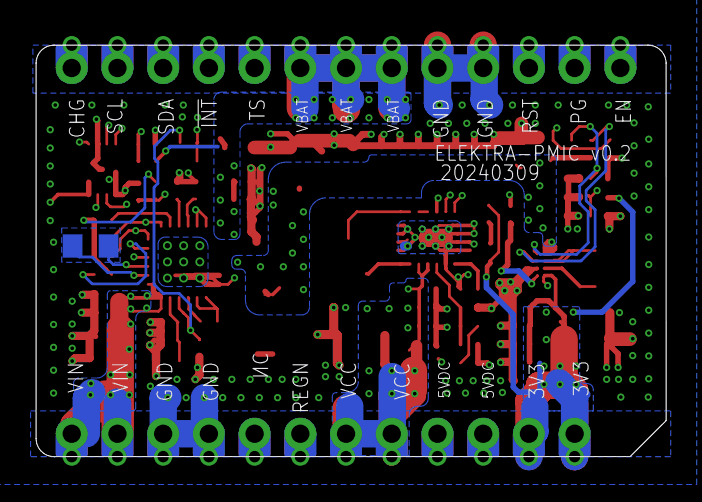
[picture p36: board ELEKTRA-PMIC v0.2-35X22.86-0.8.brd from below]

Board: 4 copper layers, 35.0 x 22.9 mm, 93 parts (19 on the bottom side), 38 nets.
