particle-iot/power-module/PM-BAT/V0.1/ELEKTRA-PMIC v0.1-20240112.brd

## EAGLE design PM-BAT/V0.1/ELEKTRA-PMIC v0.1-20240112.brd (2024-02-01, an earlier design)

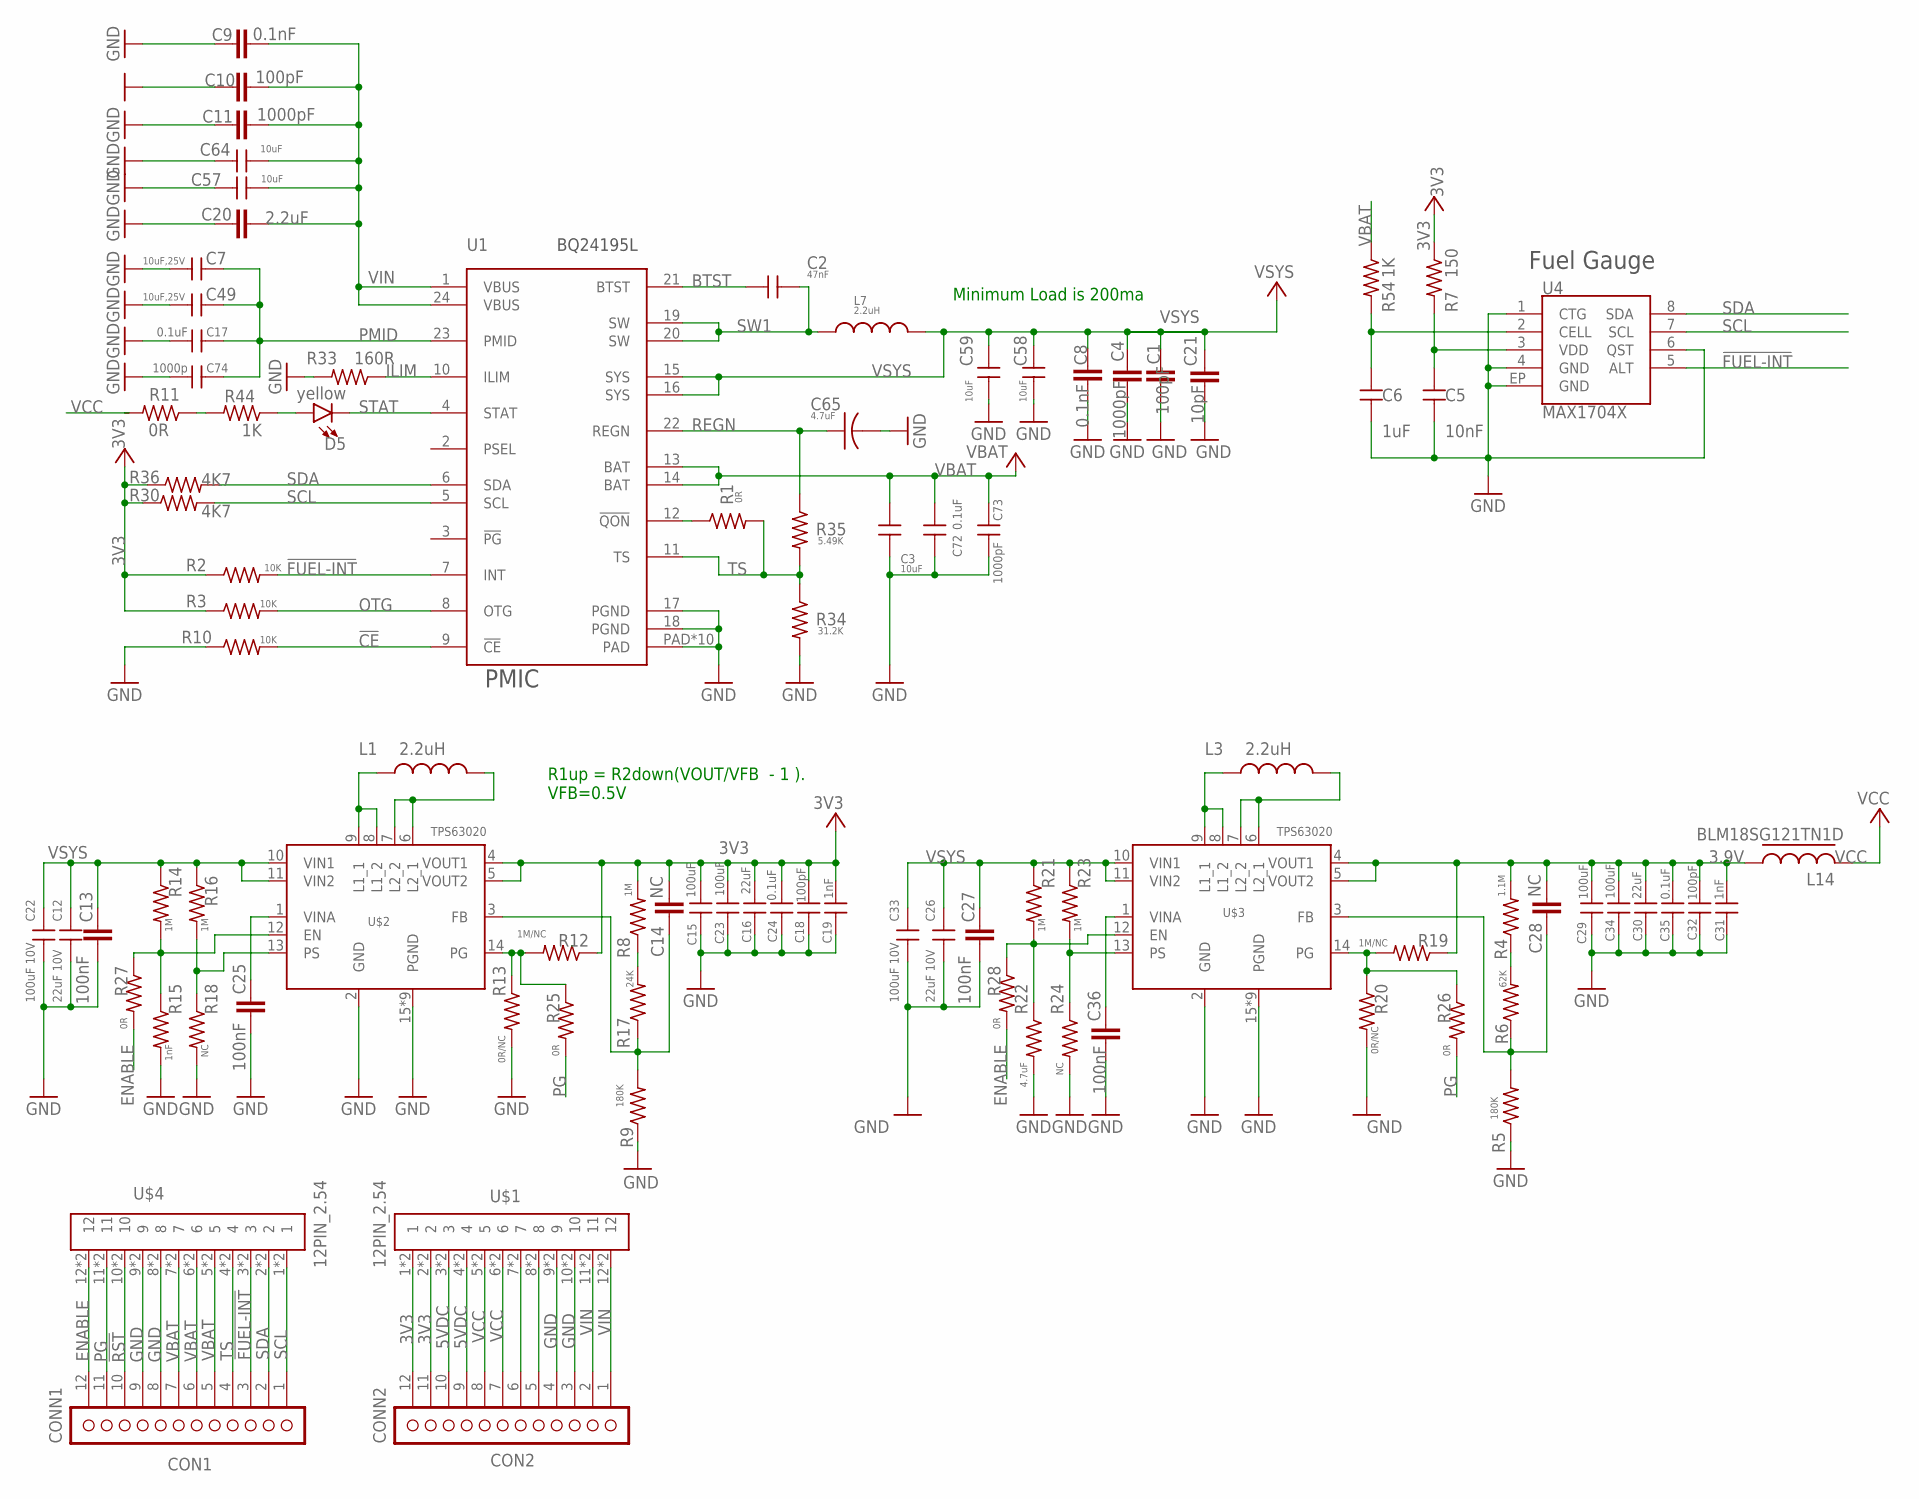
[picture p37: schematic ELEKTRA-PMIC v0.1-20240112.sch]

Parts:
C1, C10: 100pF; C0402_B
C2: 47nF; C-0402
C3: 10uF; C0603
C4, C11: 1000pF; C0402_B
C5: 10nF; C0402
C6: 1uF; C0402
C7, C49: 10uF,25V; C-0603A
C8, C9: 0.1nF; C0402_B
C12, C26: 22uF 10V; C0805
C13, C25, C27, C36: 100nF; C0402_B
C14, C28: NC; C0402_B
C15, C23, C29, C34: 100uF; C1206
C16, C30: 22uF; C-0603A
C17, C24, C35: 0.1uF; C0402
C18, C32: 100pF; C0402
C19, C31: 1nF; C0402
C20: 2.2uF; C0402_B
C21: 10pF; C0402_B
C22, C33: 100uF 10V; C1206
C57, C58, C59, C64: 10uF; C-0603A
C65: 4.7uF; C0603_B
C72: 0.1uF; C-0402
C73: 1000pF; C-0402
C74: 1000p; C-0402
CONN1: CON1; 1X12_SMD_STRAIGHT
CONN2: CON2; 1X12_SMD_STRAIGHT
D5: yellow; LED-0603
L1, L3: 2.2uH; INDUCTOR-VLS-E
L7: 2.2uH; INDUCTOR-4040
L14: BLM18SG121TN1D; R-0603A
R1, R11, R25, R26, R27, R28: 0R; R0402_B
R2, R3, R10: 10K; R0402_B
R4: 1.1M; R0402_B
R5, R9: 180K; R0402_B
R6: 62K; R0402_B
R7: 150; R0402_B
R8, R14, R16, R21, R23: 1M; R0402_B
R12, R19: 1M/NC; R0402_B
R13, R20: 0R/NC; R0402_B
R15: 1nF; R0402_B
R17: 24K; R0402_B
R18, R24: NC; R0402_B
R22: 4.7uF; R0402_B
R30, R36: 4K7; R0402_B
R33: 160R; R0402_B
R34: 31.2K; R0402_B
R35: 5.49K; R0402_B
R44, R54: 1K; R0402_B
U1: BQ24195L; QFN24
U4: MAX1704X; TDFN-8
U$1, U$4: 12PIN_2.54
U$2, U$3: TPS63020

Connections:
3.9V: C28.2, C29.1, C30.1, C31.1, C32.1, C34.1, C35.1, L14.2, R4.2, R19.1, U$3.4 (VOUT1), U$3.5 (VOUT2)
3V3: C14.2, C15.1, C16.1, C18.1, C19.1, C23.1, C24.1, CONN2.11, CONN2.12, R2.1, R3.1, R7.1, R8.2, R12.1, R30.1, R36.1, U$1.1, U$1.2, U$1.P$1 (1), U$1.P$2 (2), U$2.4 (VOUT1), U$2.5 (VOUT2)
5VDC: CONN2.9, CONN2.10, U$1.3, U$1.4, U$1.P$3 (3), U$1.P$4 (4)
!CE: R10.2, U1.9 (!CE)
!FUEL-INT: CONN1.3, R2.2, U1.7 (INT), U4.5 (ALT), U$4.3, U$4.P$3 (3)
!RST: CONN1.10, U$4.10, U$4.P$10 (10)
BTST: C2.1, U1.21 (BTST)
ENABLE: CONN1.12, R27.2, R28.2, U$4.12, U$4.P$12 (12)
GND: C1.1, C3.2, C4.1, C5.2, C6.2, C7.2, C8.1, C9.1, C10.1, C11.1, C12.2, C13.1, C15.2, C16.2, C17.1, C18.2, C19.2, C20.1, C21.1, C22.2, C23.2, C24.2, C25.1, C26.2, C27.1, C29.2, C30.2, C31.2, C32.2, C33.2, C34.2, C35.2, C36.1, C49.2, C57.2, C58.2, C59.2, C64.2, C65.2, C72.2, C73.2, C74.1, CONN1.8, CONN1.9, CONN2.3, CONN2.4, R5.1, R9.1, R10.1, R13.2, R15.2, R18.2, R20.2, R22.2, R24.2, R33.2, R34.2, U1.17 (PGND), U1.18 (PGND), U1.PAD, U1.PAD@1 (PAD), U1.PAD@2 (PAD), U1.PAD@3 (PAD), U1.PAD@4 (PAD), U1.PAD@5 (PAD), U1.PAD@6 (PAD), U1.PAD@7 (PAD), U1.PAD@8 (PAD), U1.PAD@9 (PAD), U4.1 (CTG), U4.4 (GND), U4.6 (QST), U4.EP (GND), U$1.9, U$1.10, U$1.P$9 (9), U$1.P$10 (10), U$2.2 (GND), U$2.15 (PGND), U$2.16 (PGND), U$2.17 (PGND), U$2.18 (PGND), U$2.19 (PGND), U$2.20 (PGND), U$2.21 (PGND), U$2.22 (PGND), U$2.23 (PGND), U$3.2 (GND), U$3.15 (PGND), U$3.16 (PGND), U$3.17 (PGND), U$3.18 (PGND), U$3.19 (PGND), U$3.20 (PGND), U$3.21 (PGND), U$3.22 (PGND), U$3.23 (PGND), U$4.8, U$4.9, U$4.P$8 (8), U$4.P$9 (9)
ILIM: R33.1, U1.10 (ILIM)
unnamed: R1.1, U1.12 (!QON)
unnamed: R11.1, R44.2
unnamed: D5.A, R44.1
unnamed: C14.1, R9.2, R17.1, U$2.3 (FB)
unnamed: C28.1, R5.2, R6.1, U$3.3 (FB)
unnamed: CONN2.6, U$1.7, U$1.P$7 (7)
unnamed: R8.1, R17.2
unnamed: R4.1, R6.2
unnamed: CONN2.5, U$1.8, U$1.P$8 (8)
unnamed: L3.P$1 (1), U$3.8 (L1_2), U$3.9 (L1_1)
unnamed: L1.P$1 (1), U$2.8 (L1_2), U$2.9 (L1_1)
unnamed: R12.2, R13.1, R25.1, U$2.14 (PG)
unnamed: R14.2, R15.1, R27.1, U$2.12 (EN)
unnamed: R16.2, R18.1, U$2.13 (PS)
unnamed: L3.P$2 (2), U$3.6 (L2_1), U$3.7 (L2_2)
unnamed: L1.P$2 (2), U$2.6 (L2_1), U$2.7 (L2_2)
unnamed: C25.2, U$2.1 (VINA)
unnamed: C36.2, U$3.1 (VINA)
unnamed: R19.2, R20.1, R26.1, U$3.14 (PG)
unnamed: R21.2, R22.1, R28.1, U$3.12 (EN)
unnamed: R23.2, R24.1, U$3.13 (PS)
unnamed: C5.1, R7.2, U4.3 (VDD)
unnamed: C6.1, R54.2, U4.2 (CELL)
OTG: R3.2, U1.8 (OTG)
PG: CONN1.11, R25.2, R26.2, U$4.11, U$4.P$11 (11)
PMID: C7.1, C17.2, C49.1, C74.2, U1.23 (PMID)
REGN: C65.1, R35.1, U1.22 (REGN)
SCL: CONN1.1, R30.2, U1.5 (SCL), U4.7 (SCL), U$4.1, U$4.P$1 (1)
SDA: CONN1.2, R36.2, U1.6 (SDA), U4.8 (SDA), U$4.2, U$4.P$2 (2)
STAT: D5.C, U1.4 (STAT)
SW1: C2.2, L7.P$1 (1), U1.19 (SW), U1.20 (SW)
TS: CONN1.4, R1.2, R34.1, R35.2, U1.11 (TS), U$4.4, U$4.P$4 (4)
VBAT: C3.1, C72.1, C73.1, CONN1.5, CONN1.6, CONN1.7, R54.1, U1.13 (BAT), U1.14 (BAT), U$4.5, U$4.6, U$4.7, U$4.P$5 (5), U$4.P$6 (6), U$4.P$7 (7)
VCC: CONN2.7, CONN2.8, L14.1, R11.2, U$1.5, U$1.6, U$1.P$5 (5), U$1.P$6 (6)
VIN: C9.2, C10.2, C11.2, C20.2, C57.1, C64.1, CONN2.1, CONN2.2, U1.1 (VBUS), U1.24 (VBUS), U$1.11, U$1.12, U$1.P$11 (11), U$1.P$12 (12)
VSYS: C1.2, C4.2, C8.2, C12.1, C13.2, C21.2, C22.1, C26.1, C27.2, C33.1, C58.1, C59.1, L7.P$2 (2), R14.1, R16.1, R21.1, R23.1, U1.15 (SYS), U1.16 (SYS), U$2.10 (VIN1), U$2.11 (VIN2), U$3.10 (VIN1), U$3.11 (VIN2)

Notes on the sheet:
Minimum Load is 200ma
PMIC
Fuel Gauge
R1up = R2down(VOUT/VFB - 1 ). VFB=0.5V

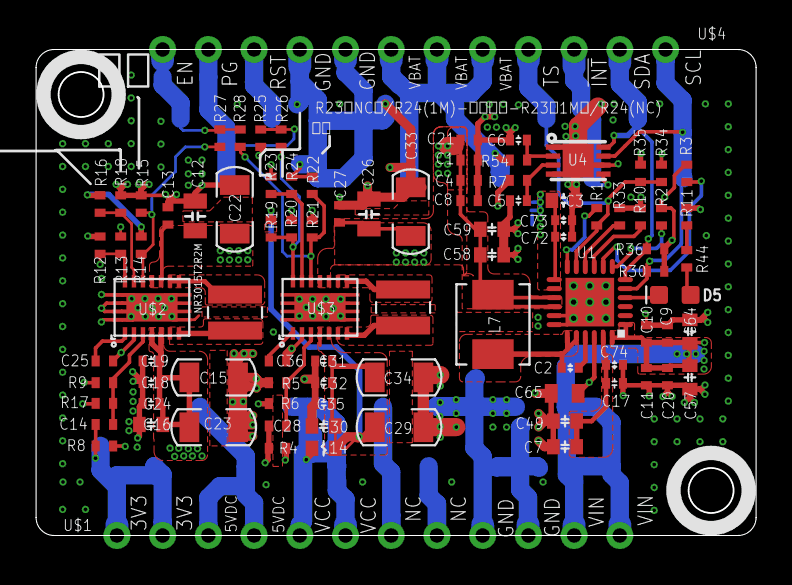
[picture p38: board ELEKTRA-PMIC v0.1-20240112.brd from above]

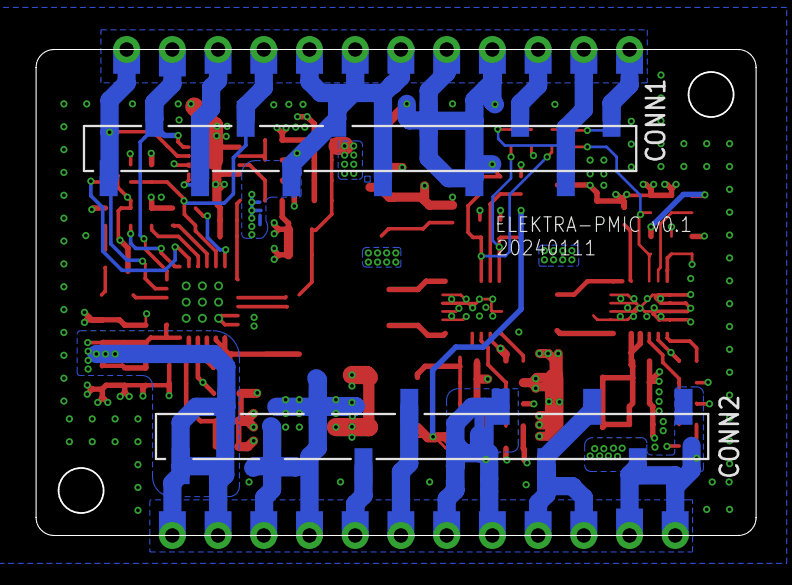
[picture p39: board ELEKTRA-PMIC v0.1-20240112.brd from below]

Board: 4 copper layers, 40.0 x 27.0 mm, 93 parts (2 on the bottom side), 46 nets.
