particle-iot/power-module/(commit log)

2024-01-04 add sch and pcb
    [ELEKTRA-BENCH v0.1-20240103.brd, ELEKTRA-BENCH v0.1-20240103.sch]
2024-01-12 Design elektra PMIC and Bench modules
    [ELEKTRA-BENCH v0.1-20240103.brd, ELEKTRA-BENCH v0.1-20240103.sch, ELEKTRA-PMIC v0.1-20240112.brd, ELEKTRA-PMIC v0.1-20240112.sch]
2024-02-01 upload PCB and sch
    upload PCB and sch
    [ELEKTRA-BENCH v0.1-20240103.brd, ELEKTRA-BENCH v0.1-20240103.sch, ELEKTRA-PMIC v0.1-20240112.brd, ELEKTRA-PMIC v0.1-20240112.sch]
2024-03-06 Placement
    modify the one of DC_DC and pcb size
    [ELEKTRA-PMIC v0.2-35X19 Half frame shield.brd, ELEKTRA-PMIC v0.2-35X19 Half frame shield.sch, ELEKTRA-PMIC v0.2-Ful frame shield -35X22m.brd, ELEKTRA-PMIC v0.2-Ful frame shield -35X22m.sch, ELEKTRA-PMIC v0.2-Half frame shield for astellated edges adjacent-35X22.brd, ELEKTRA-PMIC v0.2-Half frame shield for astellated edges adjacent-35X22.sch, ELEKTRA-PMIC v0.2-ful frame shield for astellated edges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]
2024-03-08 update palcement
    make the two connector 0.8inch
    [ELEKTRA-PMIC v0.2-Half frame shield for astellated edges adjacent-35X22.86-0.8.brd, ELEKTRA-PMIC v0.2-Half frame shield for astellated edges adjacent-35X22.86-0.8.sch]
2024-03-08 update
    layout
    [ELEKTRA-PMIC v0.2-35X22.86-0.8.brd, ELEKTRA-PMIC v0.2-35X22.86-0.8.sch]
2024-03-09 update layout
    complete the layout for power module
    [ELEKTRA-PMIC v0.2-35X22.86-0.8.brd, ELEKTRA-PMIC v0.2-35X22.86-0.8.sch]
2024-03-11 update layout
    Optimize routing
    [ELEKTRA-PMIC v0.2-35X22.86-0.8.brd, ELEKTRA-PMIC v0.2-35X22.86-0.8.sch]
2024-03-11 update
    complete layout
    [ELEKTRA-PMIC v0.2-35X22.86-0.8.sch]
2024-03-14 update the schematic for power module
    [PowerModule_v001.brd, PowerModule_v001.sch]
2024-03-14 change the name for test board
    [PowerModule_Testboard.brd, PowerModule_Testboard.sch]
2024-03-15 update the power module
    [PowerModule_Testboard.brd, PowerModule_Testboard.sch]
2024-03-21 update the design for power module test board and generate the gerber
    [PowerModule_Testboard.brd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]
2024-03-23 Delete ELEKTRA-PMIC/V0.2 directory
    this is just a PCB placement for review ,it is not needed right now
    [ELEKTRA-PMIC v0.2-35X19 Half frame shield.brd, ELEKTRA-PMIC v0.2-35X19 Half frame shield.sch, ELEKTRA-PMIC v0.2-Ful frame shield -35X22m.brd, ELEKTRA-PMIC v0.2-Ful frame shield -35X22m.sch, ELEKTRA-PMIC v0.2-Half frame shield for astellated edges adjacent-35X22.86-0.8.brd, ELEKTRA-PMIC v0.2-Half frame shield for astellated edges adjacent-35X22.86-0.8.sch, ELEKTRA-PMIC v0.2-Half frame shield for a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]
2024-03-23 Update
    Change PCB silkscreen
    Add GND pad
    Add tranker code location
    [ELEKTRA-PMIC v0.3-35X22.86-0.8-323.brd, ELEKTRA-PMIC v0.3-35X22.86-0.8-323.sch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]
2024-03-23 add gerber
    add gerber
    [copper_bottom_l4.gbr, copper_inner_l2.gbr, copper_inner_l3.gbr, copper_top_l1.gbr, drill_1_16.xln, gerber_job.gbrjob, profile.gbr, silkscreen_bottom.gbr]
2024-03-25 update the design file
    [PowerModule_Testboard.brd, PowerModule_Testboard.sch, PowerModule_Testboard_v0.0.2.brd, PowerModule_Testboard_v0.0.2.sch]
2024-04-03 update the power module v0.0.2
    [PowerModule_Testboard_v0.0.2.brd, PowerModule_Testboard_v0.0.2.sch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]
2024-04-03 Update SCH&PCB
    V0.4 Change list:
    1. Add resistor R13
    2. Add load switch circuit U5
    3. An EN_AUX PIN is added to the NC of the connector to control the load switch, and the position of the REGN pin is exchanged to better layout
    4. Update R9, R18, R17 parameters
    5. Some resistors are changed to 0201 footprint
    [ELEKTRA-PMIC v0.4-35X22.86.brd, ELEKTRA-PMIC v0.4-35X22.86.sch]
2024-04-03 update PM_DC
    [ELEKTRA-BENCH v0.1-20240103.brd, ELEKTRA-BENCH v0.1-20240103.sch, PM_DC_v0.2.brd, PM_DC_v0.2.sch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]
2024-04-03 update
    change the name as PM-BAT
    [ELEKTRA-PMIC v0.1-20240112.brd, ELEKTRA-PMIC v0.1-20240112.sch, ELEKTRA-PMIC v0.2-35X22.86-0.8.brd, ELEKTRA-PMIC v0.2-35X22.86-0.8.sch, ELEKTRA-PMIC v0.3-35X22.86-0.8-323.brd, ELEKTRA-PMIC v0.3-35X22.86-0.8-323.sch, PM-BAT v0.4-35X22.86.brd, PM-BAT v0.4-35X22.86.sch]
2024-04-10 update
    add shield case DXF
    [PM-BAT v0.4-35X22.86.sch, PM-BAT v0.4-35X22.86DXF-shape 1.94mm.dxf, PM-BAT v0.4-35X22.86DXF-shape with max Components height1.94mm.dxf]
2024-04-15 update
    1.add load Switch IC
    2.change some footprint 0201 as 0401
    3.re-placement and re-layout
    [PM_DC_v0.3.brd, PM_DC_v0.3.sch]
2024-04-15 update
    Optimize layout
    [PM_DC_v0.3.brd]
2024-04-24 update
    output gerber for MO DFM
    [PM-BAT v0.4-35X22.86.brd, PM-BAT v0.4-35X22.86.sch, PM_DC_v0.3.brd, PM_DC_v0.3.sch]
2024-04-26 update
    update
    [PM-BAT v0.4-35X22.86.sch]
2024-04-30 updae
    1.Increase the distance between the shield and the connector
    2.Modify silk screen mark
    3.for PM-DC:Change the inductor and diode to lower the height
    [PM-BAT v0.5-35X22.86.brd, PM-BAT v0.5-35X22.86.sch, PM_DC_v0.4.brd, PM_DC_v0.4.sch]
2024-05-06 update
    update and output DXF for DFM
    [PM-BAT v0.4-35X22.86DXF-shape 1.94mm.dxf, PM-BAT v0.4-35X22.86DXF-shape with max Components height1.94mm.dxf, PM-BAT v0.5-35X22.86-DXF-MAX Components Height 2mm.dxf, PM-BAT v0.5-35X22.86-DXF.brd, PM-BAT v0.5-35X22.86.sch, PM_DC_v0.4DXF-MAX Components Height 2mm.dxf, PM_DC_v0.4DXF.brd]
2024-05-15 update the test board v0.0.3
    [PowerModule_Testboard_v0.0.3.brd, PowerModule_Testboard_v0.0.3.sch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]
2024-06-03 upload xydate and placement and update based test
    [ELEKTRA-BENCH v0.1-20240103.brd, ELEKTRA-BENCH v0.1-20240103.sch, PM-BAT v0.5-35X22.86.brd, PM-BAT v0.5-35X22.86.sch, PM_DC_v0.2.brd, PM_DC_v0.2.sch, PM_DC_v0.3.brd, PM_DC_v0.3.sch]
2024-08-01 Create v1.0 file
    [PM-BAT v1.0-35X22.86.brd, PM-BAT v1.0-35X22.86.sch, PM_DC_v1.0.brd, PM_DC_v1.0.sch]
2024-08-02 Adjust the version silkscreen position.
    [PM-BAT v1.0-35X22.86.brd]
